constancees/BMI-EMG-HW-Constance/CAD files/Bracelet 1/Assembly - Canal v12.iges

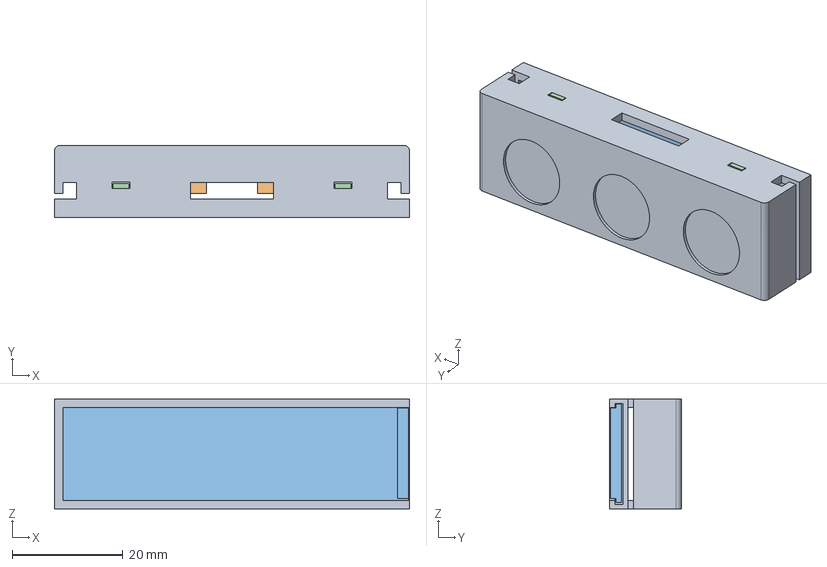
[picture p1: CAD file, 2026-05-24]
CAD files/Bracelet 1/Assembly - Canal v12.iges
64.0 x 13.0 x 19.8 mm
