constancees/BMI-EMG-HW-Constance/CAD files/Bracelet 2/Canal - Assembly v11.iges

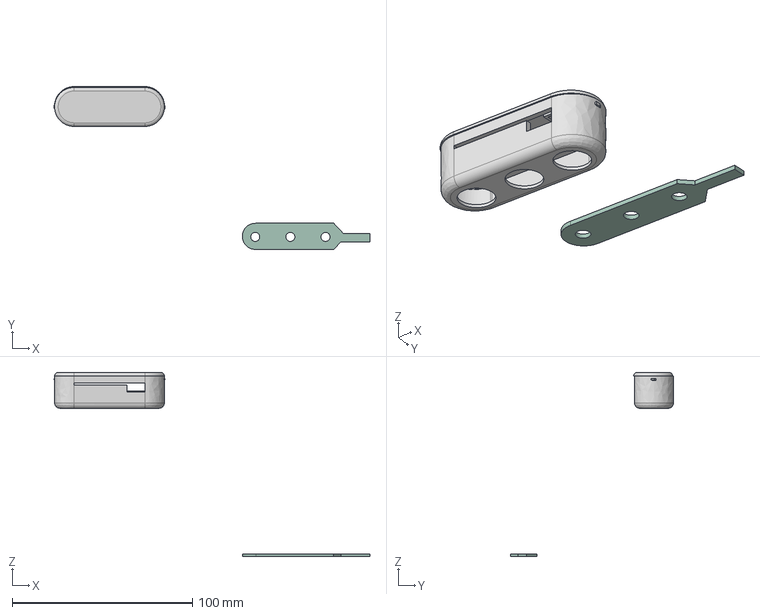
[picture p2: CAD file, 2026-05-24]
CAD files/Bracelet 2/Canal - Assembly v11.iges
175.3 x 90.4 x 102.3 mm
