constancees/BMI-EMG-HW-Constance/CAD files/Bracelet 1/Assembly - Control Board v1.iges

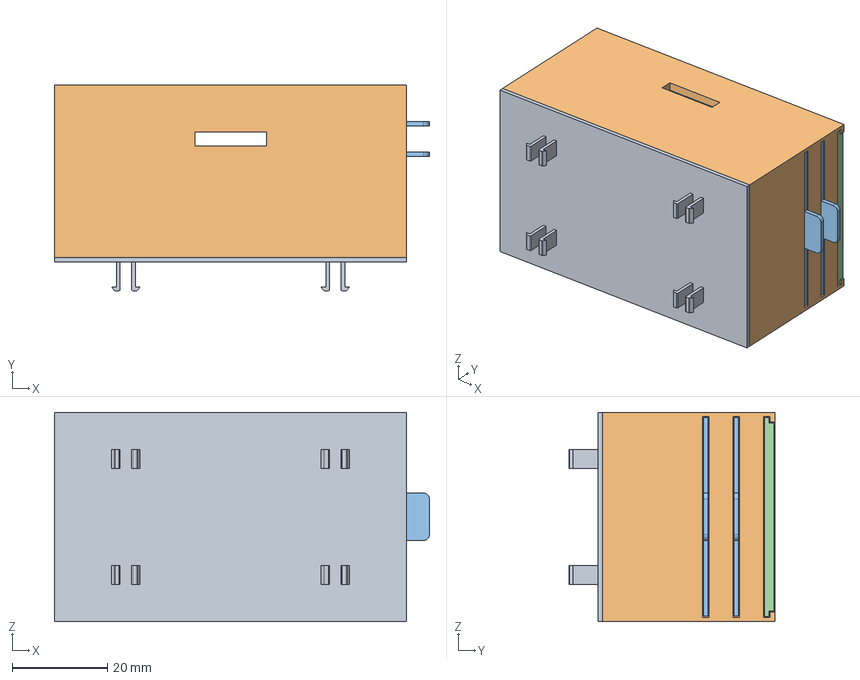
[picture p3: CAD file, 2026-05-24]
CAD files/Bracelet 1/Assembly - Control Board v1.iges
78.8 x 43.2 x 44.0 mm
