constancees/BMI-EMG-HW-Constance/CAD files/Bracelet 1/Canal - main base v9.iges

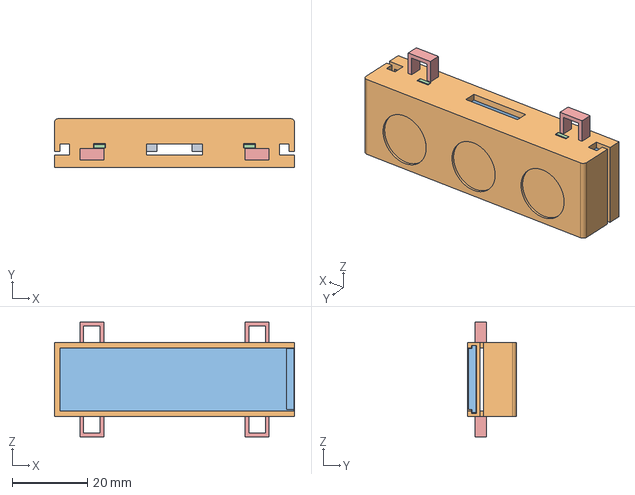
[picture p4: CAD file, 2026-05-24]
CAD files/Bracelet 1/Canal - main base v9.iges
64.0 x 13.0 x 30.6 mm
