constancees/BMI-EMG-HW-Constance/POWERBOARD v3/power_v3.3/APP2281-1FMG-7/AP2281-1FMG-7.stp

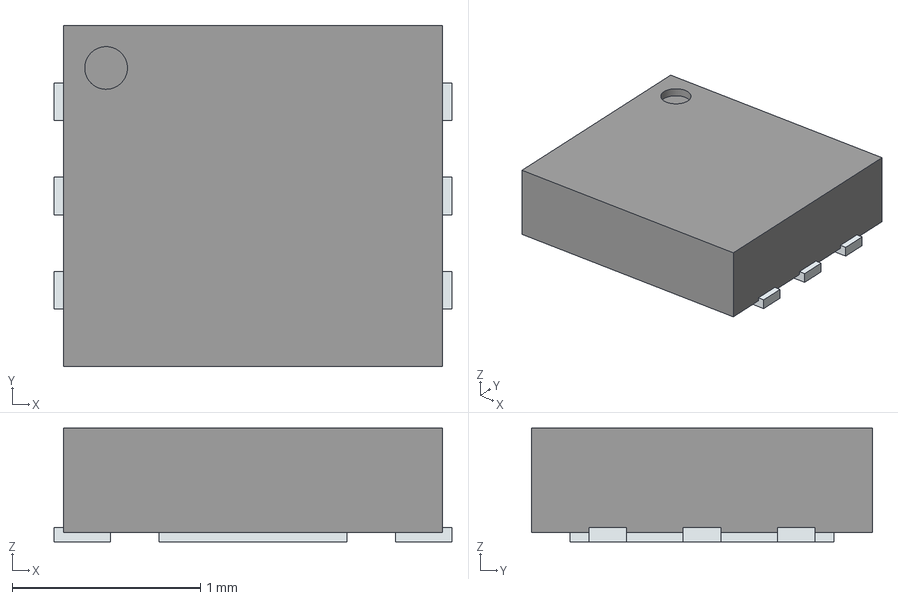
[picture p5: CAD file, 2026-10-09]
POWERBOARD v3/power_v3.3/APP2281-1FMG-7/AP2281-1FMG-7.stp
2.11 x 1.81 x 0.605 mm
ThermalPin
PinsArrayLR
