constancees/BMI-EMG-HW-Constance/POWERBOARD v3/power_v3.3/MCP6541T-I_OT/MCP6541T-I_OT.stp

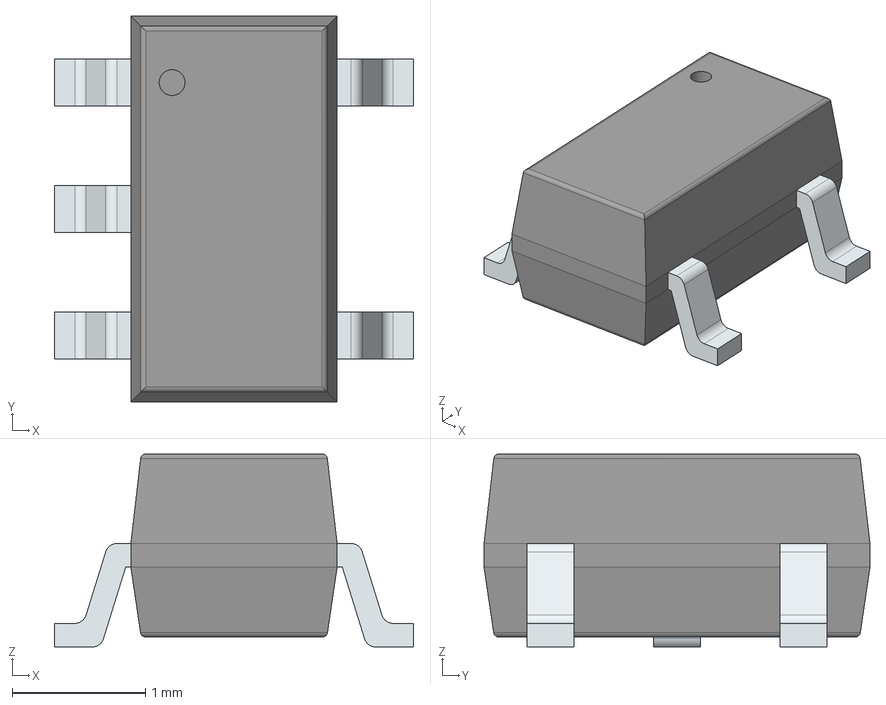
[picture p6: CAD file, 2026-10-09]
POWERBOARD v3/power_v3.3/MCP6541T-I_OT/MCP6541T-I_OT.stp
2.70 x 2.90 x 1.45 mm
PinsArrayL
PinsArrayR
