constancees/BMI-EMG-HW-Constance/POWERBOARD v3/power_v3.3/MFS201N-9-Z/MFS201N-9-Z.stp

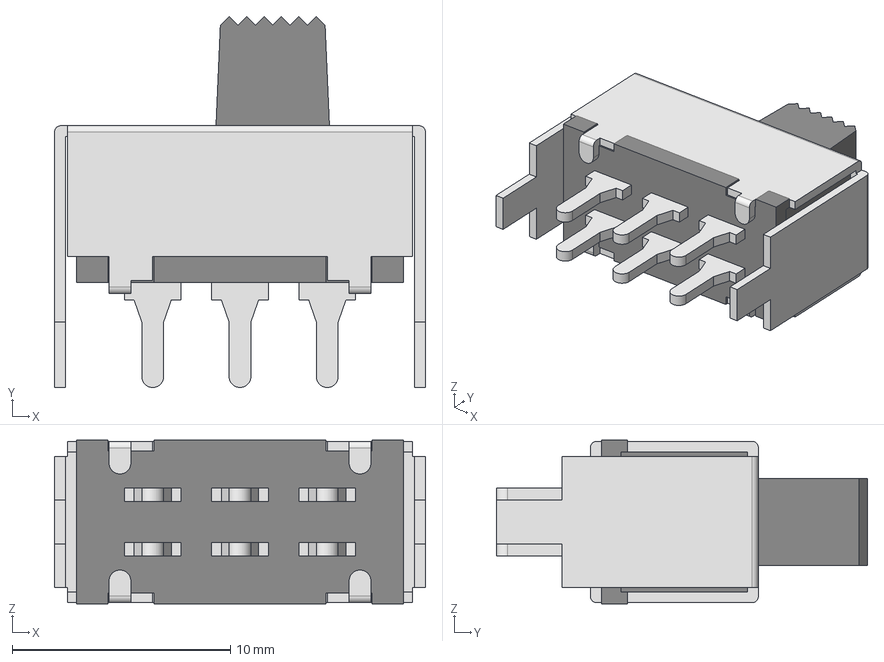
[picture p7: CAD file, 2026-10-09]
POWERBOARD v3/power_v3.3/MFS201N-9-Z/MFS201N-9-Z.stp
17.0 x 17.0 x 7.50 mm
MFS201N-9-Z_b
MFS201N910_bu
