constancees/BMI-EMG-HW-Constance/POWERBOARD v3/power_v3.3/SMBJ9.0A/SMBJ9.0A.stp

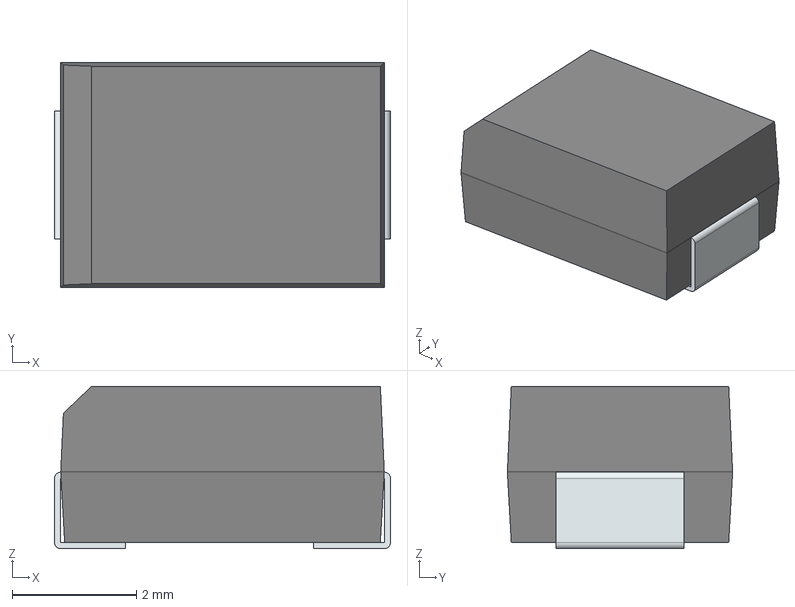
[picture p8: CAD file, 2026-10-09]
POWERBOARD v3/power_v3.3/SMBJ9.0A/SMBJ9.0A.stp
5.40 x 3.62 x 2.61 mm
FilletPin1
FilletPin2
