constancees/BMI-EMG-HW-Constance/POWERBOARD v3/power_v3.3/switchonoff/5MS1S102AM6QES.stp

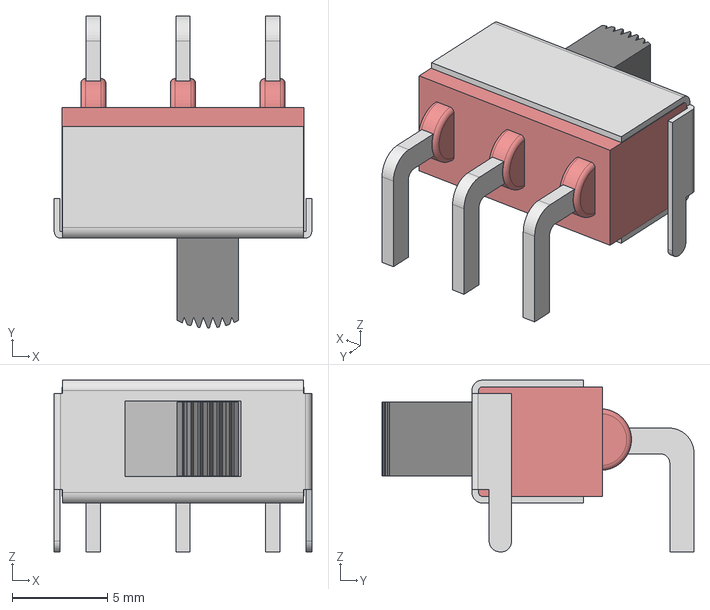
[picture p9: CAD file, 2026-10-09]
POWERBOARD v3/power_v3.3/switchonoff/5MS1S102AM6QES.stp
13.5 x 16.4 x 9.01 mm
