constancees/BMI-EMG-HW-Constance/POWERBOARD v3/power_v3.3/UJ20_C_H_G_SMT_1_P16_TR/UJ20-C-H-G-SMT-1-P16-TR.step

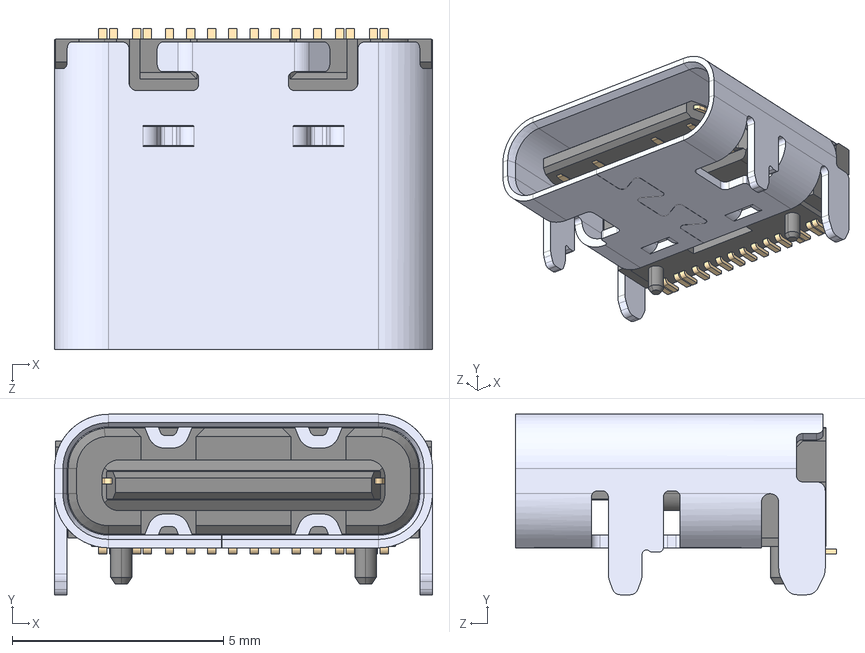
[picture p10: CAD file, 2026-10-08]
POWERBOARD v3/power_v3.3/UJ20_C_H_G_SMT_1_P16_TR/UJ20-C-H-G-SMT-1-P16-TR.step
8.94 x 4.27 x 7.60 mm
