constancees/BMI-EMG-HW-Constance/POWERBOARD v3/power_v3.3/2053380003.stp

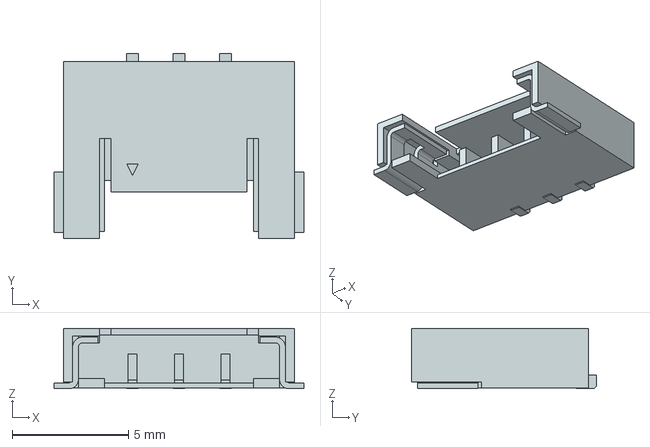
[picture p11: CAD file, 2026-10-09]
POWERBOARD v3/power_v3.3/2053380003.stp
10.7 x 7.95 x 2.60 mm
