constancees/BMI-EMG-HW-Constance/POWERBOARD v3/power_v3.3/74438336010/3D/74438336010.stp

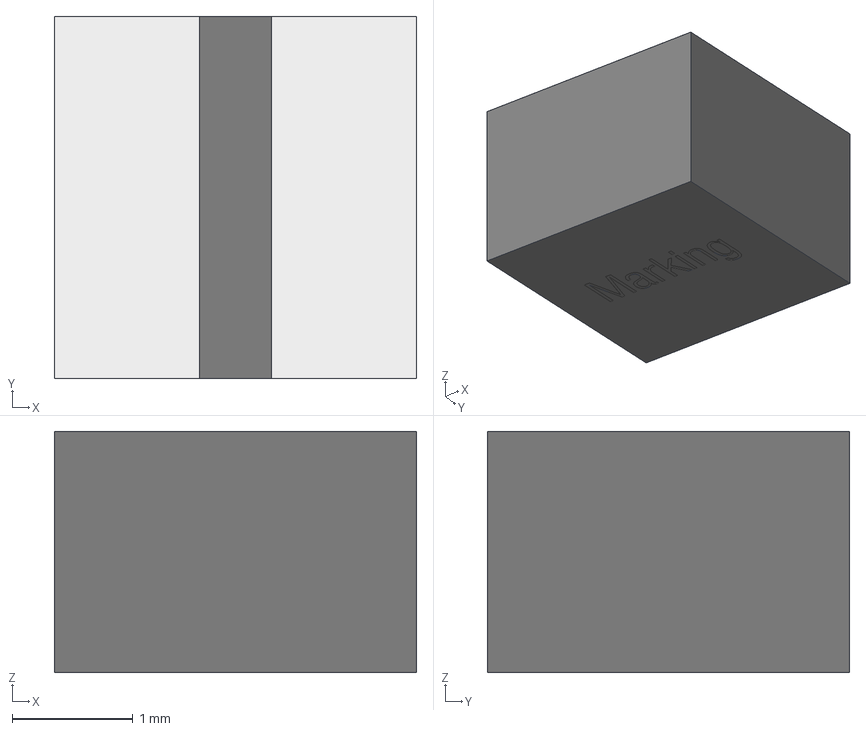
[picture p12: CAD file, 2026-10-07]
POWERBOARD v3/power_v3.3/74438336010/3D/74438336010.stp
3.00 x 3.00 x 2.00 mm
