constancees/BMI-EMG-HW-Constance/POWERBOARD v3/power_v3.3/bat_connect_new/43650-0300.stp

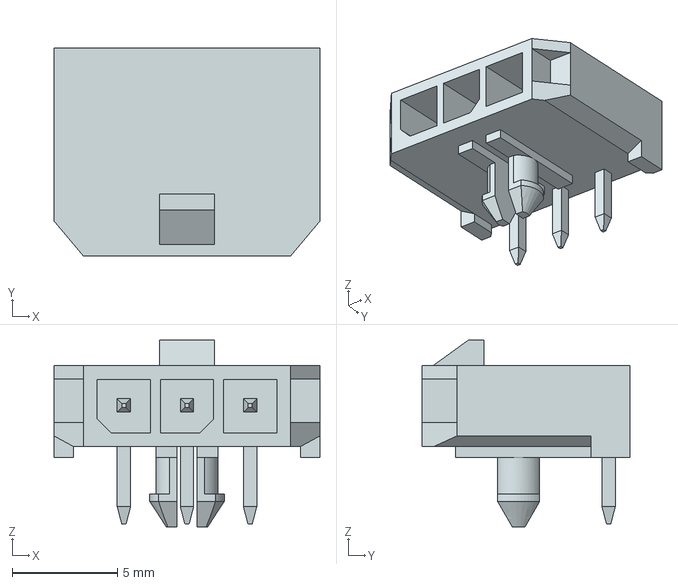
[picture p13: CAD file, 2026-10-09]
POWERBOARD v3/power_v3.3/bat_connect_new/43650-0300.stp
12.7 x 9.90 x 8.87 mm
