constancees/BMI-EMG-HW-Constance/POWERBOARD v3/power_v3.3/MAX25301AATB_V+T/MAX25301AATB_V+T.stp

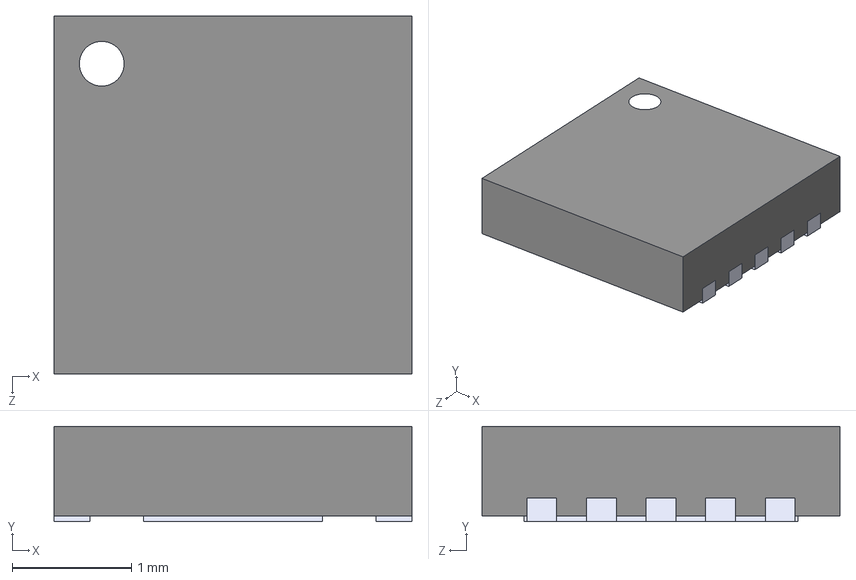
[picture p14: CAD file, 2026-10-09]
POWERBOARD v3/power_v3.3/MAX25301AATB_V+T/MAX25301AATB_V+T.stp
3.00 x 0.8 x 3.00 mm
