constancees/BMI-EMG-HW-Constance/POWERBOARD v3/power_v3.3/molex2/2053380002.stp

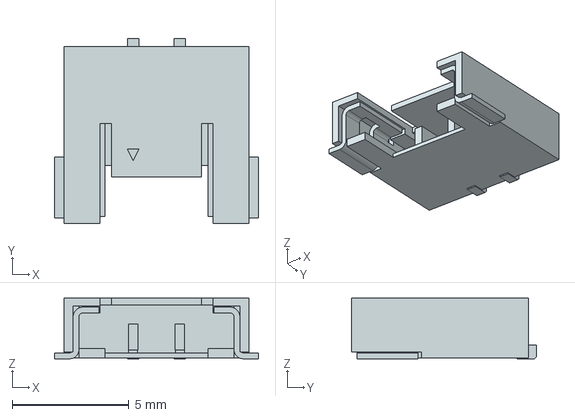
[picture p15: CAD file, 2026-10-09]
POWERBOARD v3/power_v3.3/molex2/2053380002.stp
8.75 x 7.95 x 2.60 mm
