constancees/BMI-EMG-HW-Constance/POWERBOARD v3/power_v3.3/TPS62160DSGT/TPS62160DSGT.stp

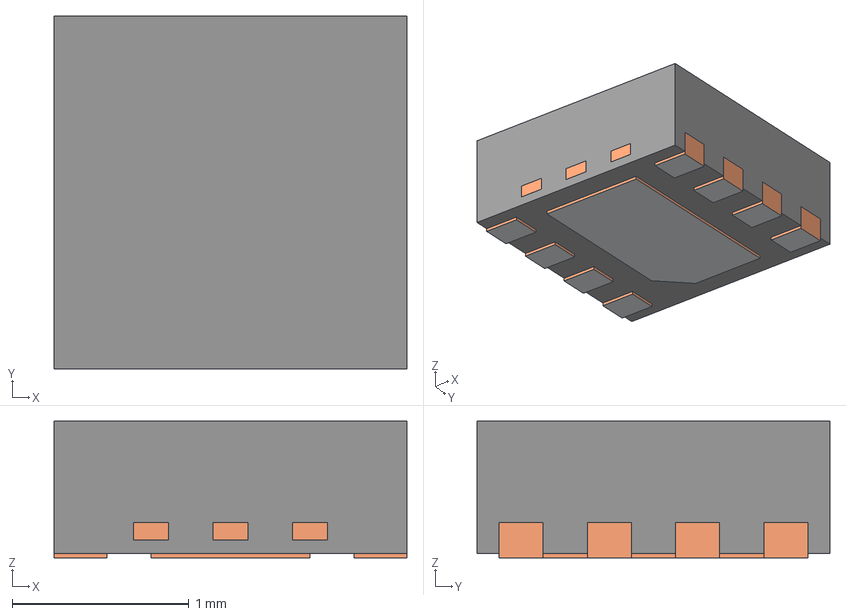
[picture p16: CAD file, 2026-10-09]
POWERBOARD v3/power_v3.3/TPS62160DSGT/TPS62160DSGT.stp
2.00 x 2.00 x 0.775 mm
BODY-SON
FRAME-DSG0008A
PIN1-ID
