constancees/BMI-EMG-HW-Constance/CAD files/Bracelet 1/Canal - main base v2.iges

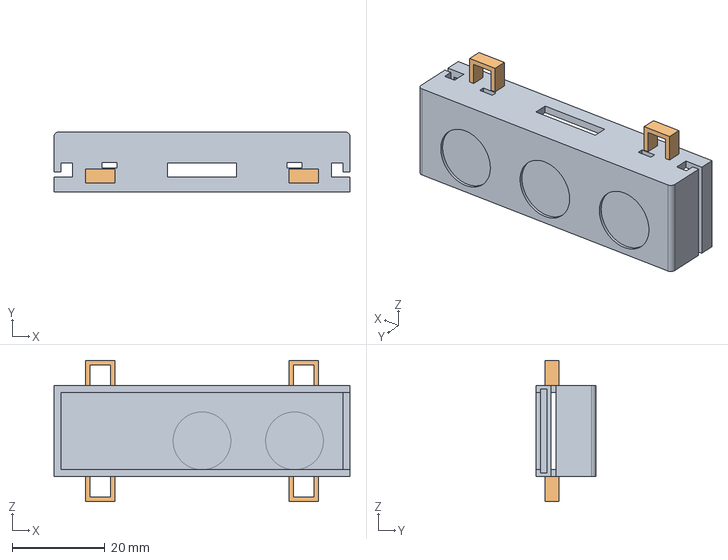
[picture p17: CAD file, 2026-05-24, an earlier design]
CAD files/Bracelet 1/Canal - main base v2.iges
64.0 x 13.0 x 30.6 mm
