constancees/BMI-EMG-HW-Constance/(list of files, cad)

Other CAD files:
POWERBOARD v3/power_v3.3/78438336022/78438336022.stp
CAD files/Bracelet 1/Canal - base v22.f3d
CAD files/Bracelet 1/Canal - blocker v2.f3d
CAD files/Bracelet 1/Canal - middle plate v8.f3d
CAD files/Bracelet 1/Canal - top plate v3.f3d
CAD files/Bracelet 1/Control board - base v10.f3d
CAD files/Bracelet 1/Control board - middle high plate v2.f3d
CAD files/Bracelet 1/Control board - middle low plate v4.f3d
CAD files/Bracelet 1/Control board - top plate v1.f3d
CAD files/Bracelet 2/Canal - Middle plate v10.f3d
CAD files/Bracelet 2/Canal - base v21.f3d
CAD files/Bracelet 2/Canal - ressort v4.f3d
CAD files/Bracelet 2/Canal - top plate bar v2.f3d
CAD files/Bracelet 2/Canal - top plate v12.f3d
CAD files/Bracelet 2/Control board - base v4.f3d
CAD files/Bracelet 2/Control board - middle plate v2.f3d
CAD files/Bracelet 2/Control board - top plate v2.f3d
CAD files/Canal - base test v3.f3d
POWERBOARD v3/power_v3.3/74438336010/DEHDL/74438336010/chips/chips.prt
