constancees/BMI-EMG-HW-Constance/(list of files, drawings)

Other design files:
POWERBOARD v3/power_v3.3/74438336010/Altium/74438336010.SchLib
POWERBOARD v3/power_v3.3/74438336010/Altium/INDC3030X200N.PcbLib
