constancees/BMI-EMG-HW-Constance/POWERBOARD v3/power_v3.3/power_v3.3.kicad_pcb

## KiCad design POWERBOARD v3/power_v3.3/power_v3.3.kicad_pcb (2026-10-09)

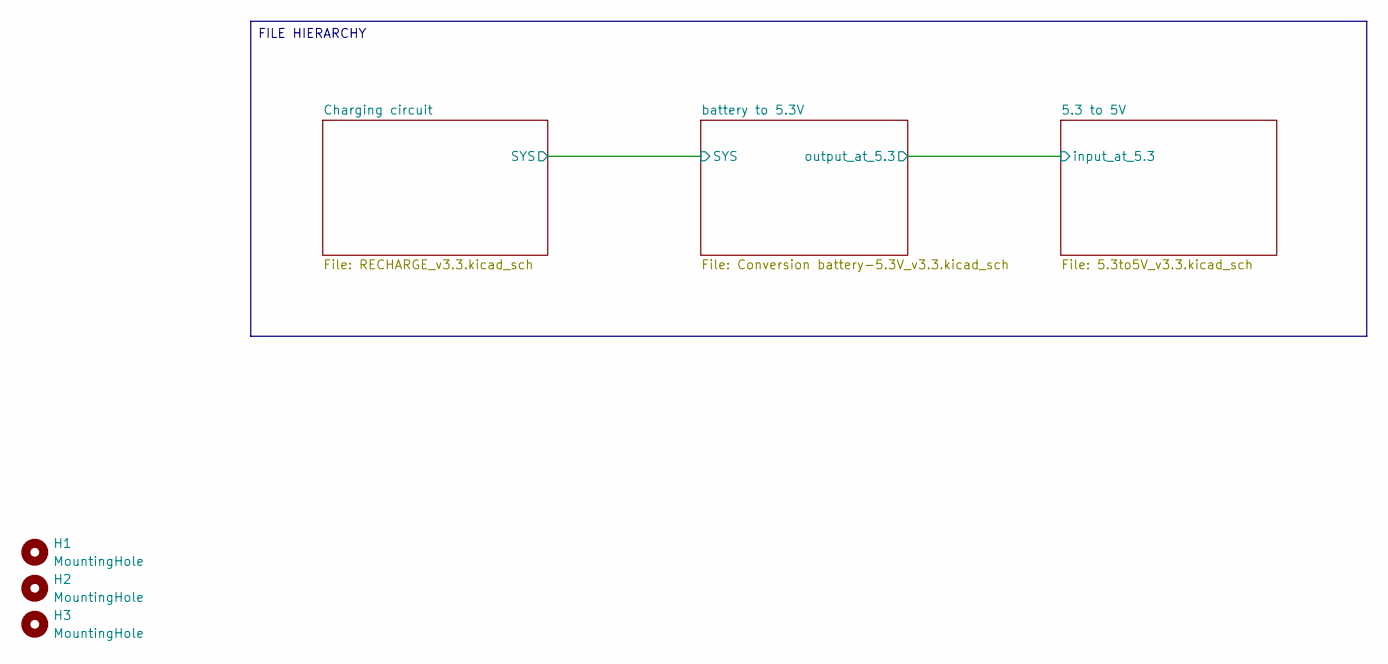
[picture p18: schematic power_v3.3.kicad_sch]

Parts:
H1, H2, H3: MountingHole; MountingHole_2.2mm_M2_DIN965_Pad

Notes on the sheet:
FILE HIERARCHY

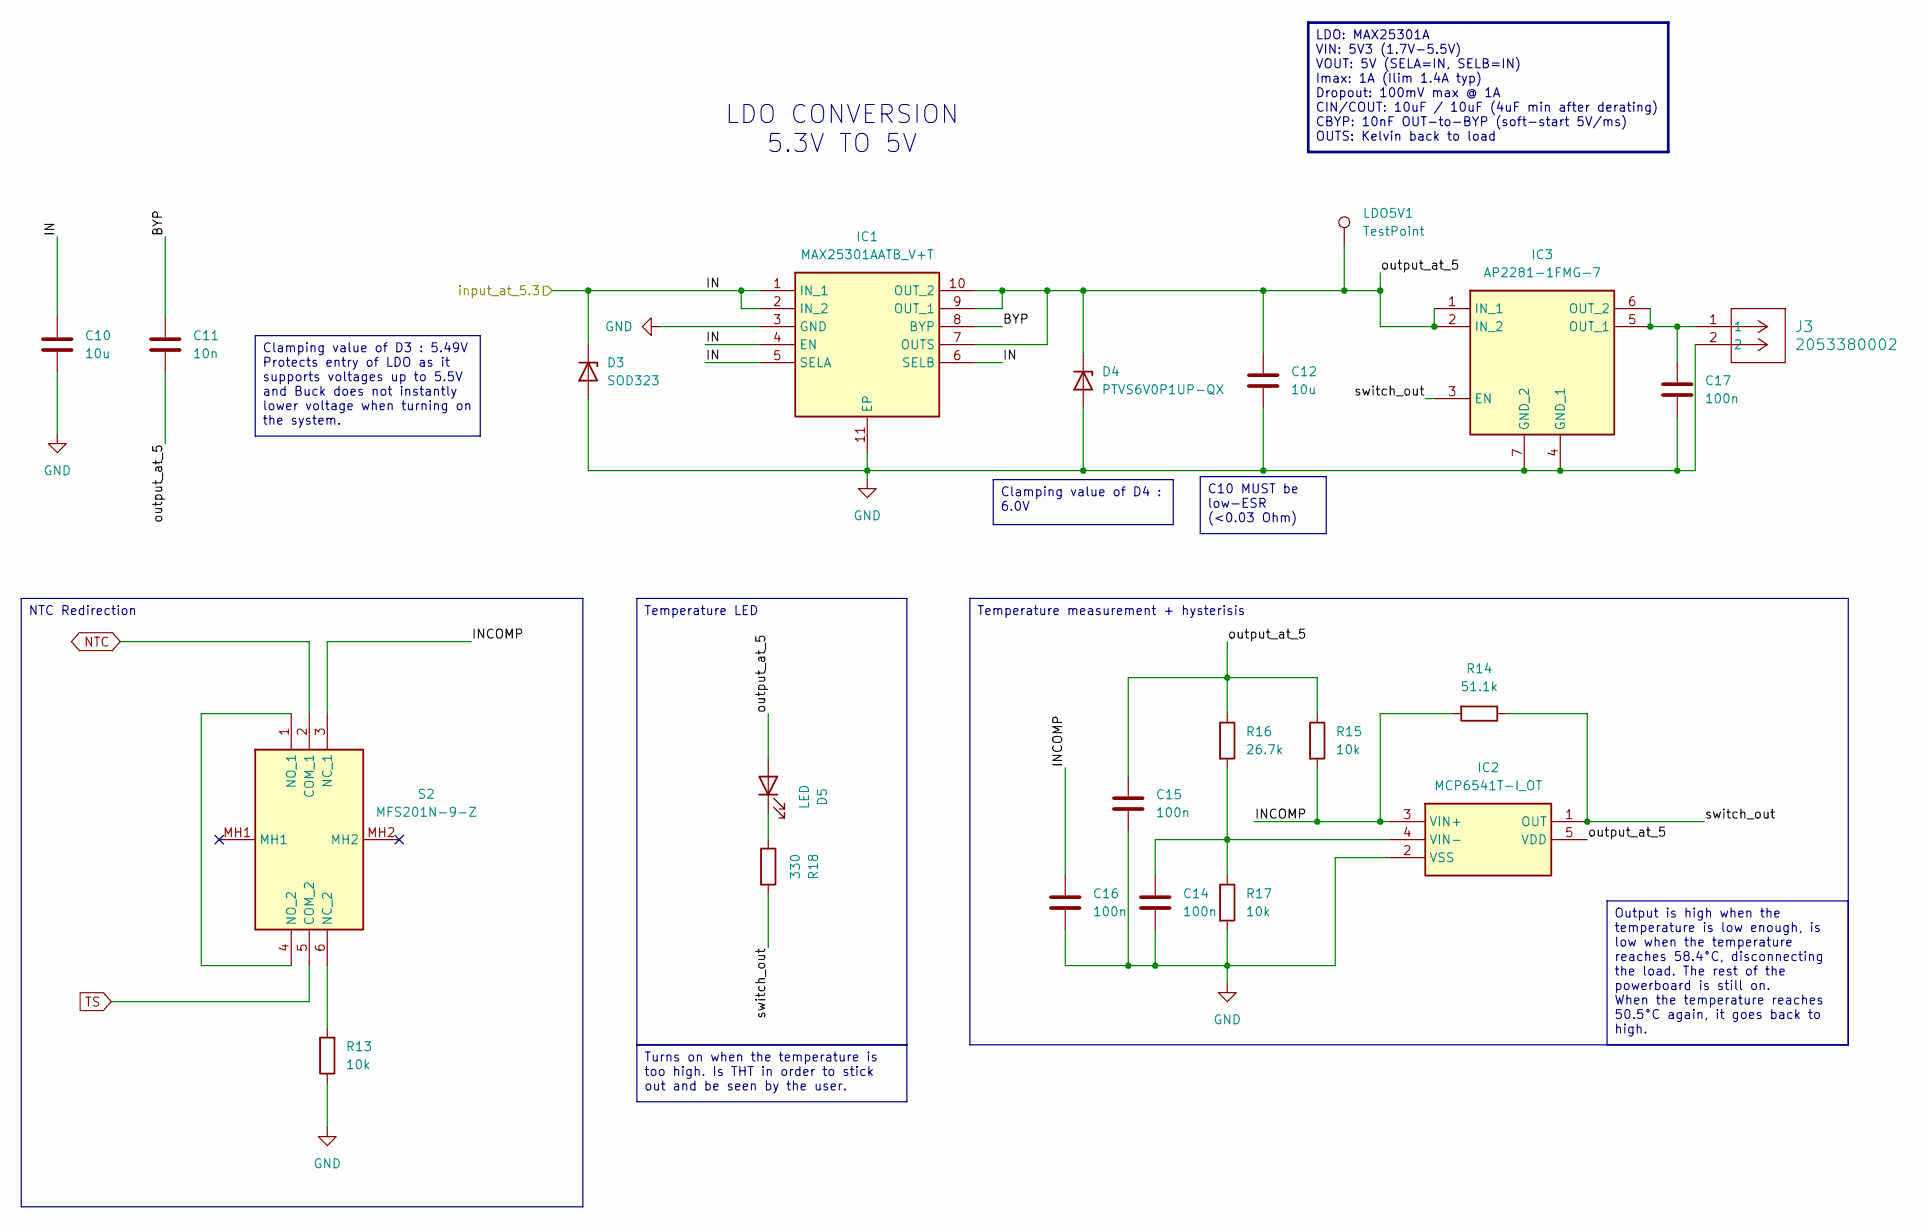
[picture p19: schematic 5.3to5V_v3.3.kicad_sch]

Parts:
C10, C12: 10u; C_0805_2012Metric
C11: 10n; C_0402_1005Metric
C14, C15, C16, C17: 100n; C_0402_1005Metric
D3: SOD323; SOT-23
D4: PTVS6V0P1UP-QX; D_SOD-128
D5: LED; LED_D5.0mm
IC1: MAX25301AATB_V+T; SON50P300X300X80-11N; Mouser Part Number 700-MAX25301AATB/V+T
IC2: MCP6541T-I_OT; SOT95P270X145-5N; Mouser Part Number 579-MCP6541T-I/OT
IC3: AP2281-1FMG-7; SON50P201X181X60-7N; Mouser Part Number 621-AP2281-1FMG-7
J3: 2053380002; CONN_2053380000-SD_02_MOL
LDO5V1: TestPoint; TestPoint_Keystone_5000-5004_Miniature
R13, R15, R17: 10k; R_0603_1608Metric
R14: 51.1k; R_0603_1608Metric
R16: 26.7k; R_0603_1608Metric
R18: 330; R_0603_1608Metric
S2: MFS201N-9-Z; MFS201N9Z; Mouser Part Number 229-MFS201N-9-Z

Connections:
/5.3 to 5V/BYP: C11.1, IC1.8 (BYP)
/5.3 to 5V/IN: C10.1, D3.1 (K), IC1.1 (IN_1), IC1.2 (IN_2), IC1.4 (EN), IC1.5 (SELA), IC1.6 (SELB); also elsewhere on the board
/5.3 to 5V/INCOMP: C16.1, IC2.3 (VIN+), R14.2, R15.2, S2.3 (NC_1)
/5.3 to 5V/output_at_5: C11.2, C12.1, C15.1, D4.1 (K), D5.2 (A), IC1.7 (OUTS), IC1.9 (OUT_1), IC1.10 (OUT_2), IC2.5 (VDD), IC3.1 (IN_1), IC3.2 (IN_2), LDO5V1.1 (1_1), R15.1, R16.1
/5.3 to 5V/switch_out: IC2.1 (OUT), IC3.3 (EN), R14.1, R18.2
GND: C10.2, C12.2, C14.2, C15.2, C16.2, C17.2, D3.2 (A), D4.2 (A), IC1.3 (GND), IC1.11 (EP), IC2.2 (VSS), IC3.4 (GND_1), IC3.7 (GND_2), J3.2, R13.1, R17.2; also elsewhere on the board
NTC: S2.2 (COM_1), S2.5 (COM_2); also elsewhere on the board
unnamed: D5.1 (K), R18.1
unnamed: C14.1, IC2.4 (VIN-), R16.2, R17.1
unnamed: C17.1, IC3.5 (OUT_1), IC3.6 (OUT_2), J3.1
unnamed: R13.2, S2.6 (NC_2)
unnamed: S2.1 (NO_1), S2.4 (NO_2)

Notes on the sheet:
LDO CONVERSION 5.3V TO 5V
LDO: MAX25301A VIN: 5V3 (1.7V-5.5V) VOUT: 5V (SELA=IN, SELB=IN) Imax: 1A (Ilim 1.4A typ) Dropout: 100mV max @ 1A CIN/COUT: 10uF / 10uF (4uF min after derating) CBYP: 10nF OUT-to-BYP (soft-start 5V/ms) OUTS: Kelvin back to load
Clamping value of D4 : 6.0V
Temperature LED
Clamping value of D3 : 5.49V Protects entry of LDO as it supports voltages up to 5.5V and Buck does not instantly lower voltage when turning on the system.
C10 MUST be low-ESR (<0.03 Ohm)
Temperature measurement + hysterisis
Output is high when the temperature is low enough, is low when the temperature reaches 58.4°C, disconnecting the load. The rest of the powerboard is still on. When the temperature reaches 50.5°C again, it goes back to high.
Turns on when the temperature is too high. Is THT in order to stick out and be seen by the user.
NTC Redirection

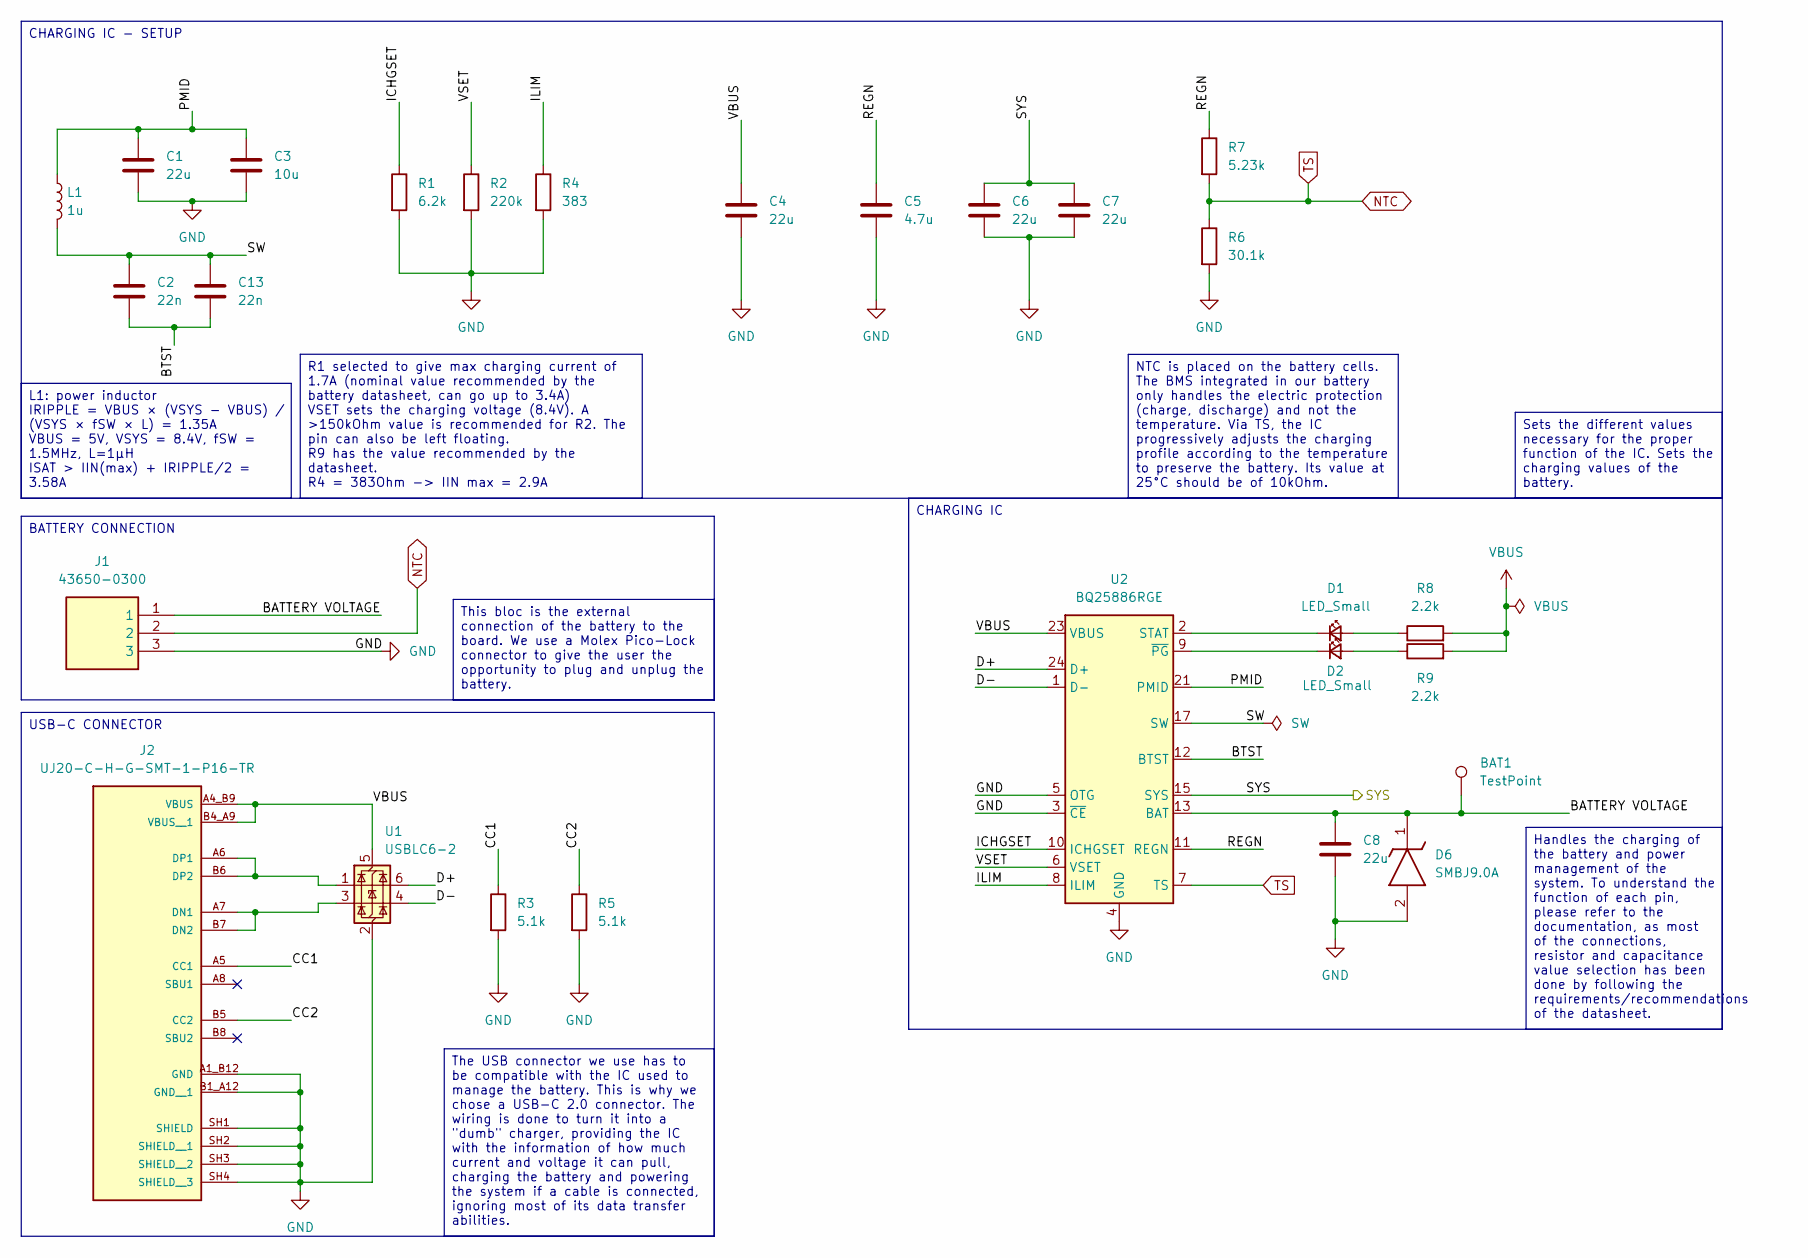
[picture p20: schematic RECHARGE_v3.3.kicad_sch]

Parts:
BAT1: TestPoint; TestPoint_Keystone_5000-5004_Miniature
C1, C4, C6, C7, C8: 22u; C_1206_3216Metric
C2, C13: 22n; C_0201_0603Metric
C3: 10u; C_0805_2012Metric
C5: 4.7u; C_0805_2012Metric
D1, D2: LED_Small; LED_0603_1608Metric
D6: SMBJ9.0A; DIOM5436X261N; Manufacturer_Part_Number SMBJ9.0A
J1: 43650-0300; 436500300; Mouser Part Number 538-43650-0300
J2: UJ20-C-H-G-SMT-1-P16-TR; SAMESKY_UJ20-C-H-G-SMT-1-P16-TR; PARTREV 1.0
L1: 1u; INDC3030X200N
R1: 6.2k; R_0603_1608Metric
R2: 220k; R_0603_1608Metric
R3, R5: 5.1k; R_0603_1608Metric
R4: 383; R_0603_1608Metric
R6: 30.1k; R_0603_1608Metric
R7: 5.23k; R_0603_1608Metric
R8, R9: 2.2k; R_0603_1608Metric
U1: USBLC6-2; SOT-23-6
U2: BQ25886RGE; Texas_RGE0024H_VQFN-24-1EP_4x4mm_P0.5mm_EP2.7x2.7mm

Connections:
/Charging circuit/BATTERY VOLTAGE: BAT1.1 (1_1), C8.1, D6.1 (K), J1.1, U2.13 (BAT), U2.14 (BAT)
/Charging circuit/BTST: C2.2, C13.2, U2.12 (BTST)
/Charging circuit/CC1: J2.A5 (CC1), R3.1
/Charging circuit/CC2: J2.B5 (CC2), R5.1
/Charging circuit/D+: U1.6 (I/O1), U2.24 (D+)
/Charging circuit/D-: U1.4 (I/O2), U2.1 (D-)
/Charging circuit/ICHGSET: R1.1, U2.10 (ICHGSET)
/Charging circuit/ILIM: R4.1, U2.8 (ILIM)
/Charging circuit/PMID: C1.1, C3.1, L1.1, U2.21 (PMID), U2.22 (PMID)
/Charging circuit/REGN: C5.1, R7.1, U2.11 (REGN)
/Charging circuit/SW: C2.1, C13.1, L1.2, U2.17 (SW), U2.18 (SW)
/Charging circuit/SYS: C6.1, C7.1, U2.15 (SYS), U2.16 (SYS); also elsewhere on the board
/Charging circuit/VSET: R2.1, U2.6 (VSET)
GND: C1.2, C3.2, C4.2, C5.2, C6.2, C7.2, C8.2, D6.2 (A), J1.3, J2.A1_B12 (GND), J2.B1_A12 (GND__1), J2.SH1 (SHIELD), J2.SH2 (SHIELD__1), J2.SH3 (SHIELD__2), J2.SH4 (SHIELD__3), R1.2, R2.2, R3.2, R4.2, R5.2, R6.2, U1.2 (GND), U2.3 (~CE), U2.4 (GND), U2.5 (OTG), U2.19 (GND), U2.20 (GND), U2.25 (GND); also elsewhere on the board
NTC: J1.2, R6.1, R7.2, U2.7 (TS); also elsewhere on the board
unnamed: D1.2 (A), R8.1
unnamed: D1.1 (K), U2.2 (STAT)
unnamed: D2.2 (A), R9.1
unnamed: D2.1 (K), U2.9 (~PG)
unnamed: J2.A7 (DN1), J2.B7 (DN2), U1.3 (I/O2)
unnamed: J2.A6 (DP1), J2.B6 (DP2), U1.1 (I/O1)
VBUS: C4.1, J2.A4_B9 (VBUS), J2.B4_A9 (VBUS__1), R8.2, R9.2, U1.5 (VBUS), U2.23 (VBUS)

Notes on the sheet:
R1 selected to give max charging current of 1.7A (nominal value recommended by the battery datasheet, can go up to 3.4A) VSET sets the charging voltage (8.4V). A >150kOhm value is recommended for R2. The pin can also be left floating. R9 has the value recommended by the datasheet. R4 = 383Ohm -> II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
This bloc is the external connection of the battery to the board. We use a Molex Pico-Lock connector to give the user the opportunity to plug and unplug the battery.
BATTERY CONNECTION
Sets the different values necessary for the proper function of the IC. Sets the charging values of the battery.
CHARGING IC - SETUP
Handles the charging of the battery and power management of the system. To understand the function of each pin, please refer to the documentation, as most of the connections, resistor and capacitance value selection has been done by following the requirements/recommendations of the datasheet.
CHARGING IC
NTC is placed on the battery cells. The BMS integrated in our battery only handles the electric protection (charge, discharge) and not the temperature. Via TS, the IC progressively adjusts the charging profile according to the temperature to preserve the battery. Its value at 25°C should be of 10kO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
USB-C CONNECTOR
The USB connector we use has to be compatible with the IC used to manage the battery. This is why we chose a USB-C 2.0 connector. The wiring is done to turn it into a "dumb" charger, providing the IC with the information of how much current and voltage it can pull, charging the battery and powering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
L1: power inductor IRIPPLE = VBUS × (VSYS − VBUS) / (VSYS × fSW × L) = 1.35A VBUS = 5V, VSYS = 8.4V, fSW = 1.5MHz, L=1µH ISAT > IIN(max) + IRIPPLE/2 = 3.58A

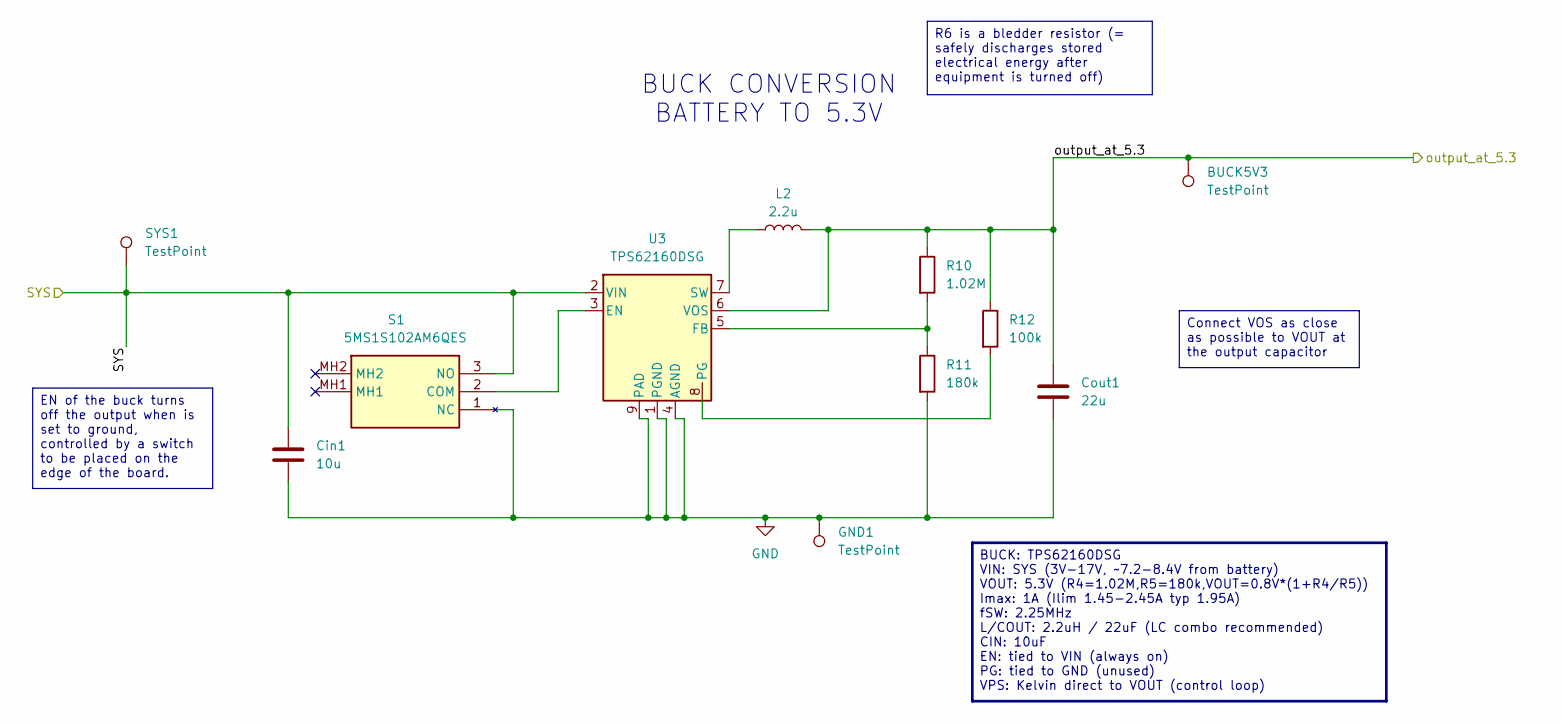
[picture p21: schematic Conversion battery-5.3V_v3.3.kicad_sch]

Parts:
BUCK5V3: TestPoint; TestPoint_Keystone_5000-5004_Miniature
Cin1: 10u; C_0805_2012Metric
Cout1: 22u; C_1206_3216Metric
GND1: TestPoint; TestPoint_Keystone_5000-5004_Miniature
L2: 2.2u; 78438336022
R10: 1.02M; R_0603_1608Metric
R11: 180k; R_0603_1608Metric
R12: 100k; R_0603_1608Metric
S1: 5MS1S102AM6QES; Mouser Part Number 118-5MS1S102AM6QES
SYS1: TestPoint; TestPoint_Keystone_5000-5004_Miniature
U3: TPS62160DSG; SON50P200X200X80-9N

Connections:
/5.3 to 5V/IN: BUCK5V3.1 (1_1), Cout1.1, L2.2, R10.1, R12.1, U3.6 (VOS); also elsewhere on the board
/Charging circuit/SYS: Cin1.1, S1.3 (NO), SYS1.1 (1_1), U3.2 (VIN); also elsewhere on the board
GND: Cin1.2, Cout1.2, GND1.1 (1_1), R11.2, S1.1 (NC), U3.1 (PGND), U3.4 (AGND), U3.9 (PAD); also elsewhere on the board
unnamed: S1.2 (COM), U3.3 (EN)
unnamed: R10.2, R11.1, U3.5 (FB)
unnamed: R12.2, U3.8 (PG)
unnamed: L2.1, U3.7 (SW)

Notes on the sheet:
BUCK CONVERSION BATTERY TO 5.3V
BUCK: TPS62160DSG VIN: SYS (3V-17V, ~7.2-8.4V from battery) VOUT: 5.3V (R4=1.02M,R5=180k,VOUT=0.8V*(1+R4/R5)) Imax: 1A (Ilim 1.45-2.45A typ 1.95A) fSW: 2.25MHz L/COUT: 2.2uH / 22uF (LC combo recommended) CIN: 10uF EN: tied to VIN (always on) PG: tied to GND (unused) VPS: Kelvin direct to VOUT (cont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
EN of the buck turns off the output when is set to ground, controlled by a switch to be placed on the edge of the board.
Connect VOS as close as possible to VOUT at the output capacitor
R6 is a bledder resistor (= safely discharges stored electrical energy after equipment is turned off)

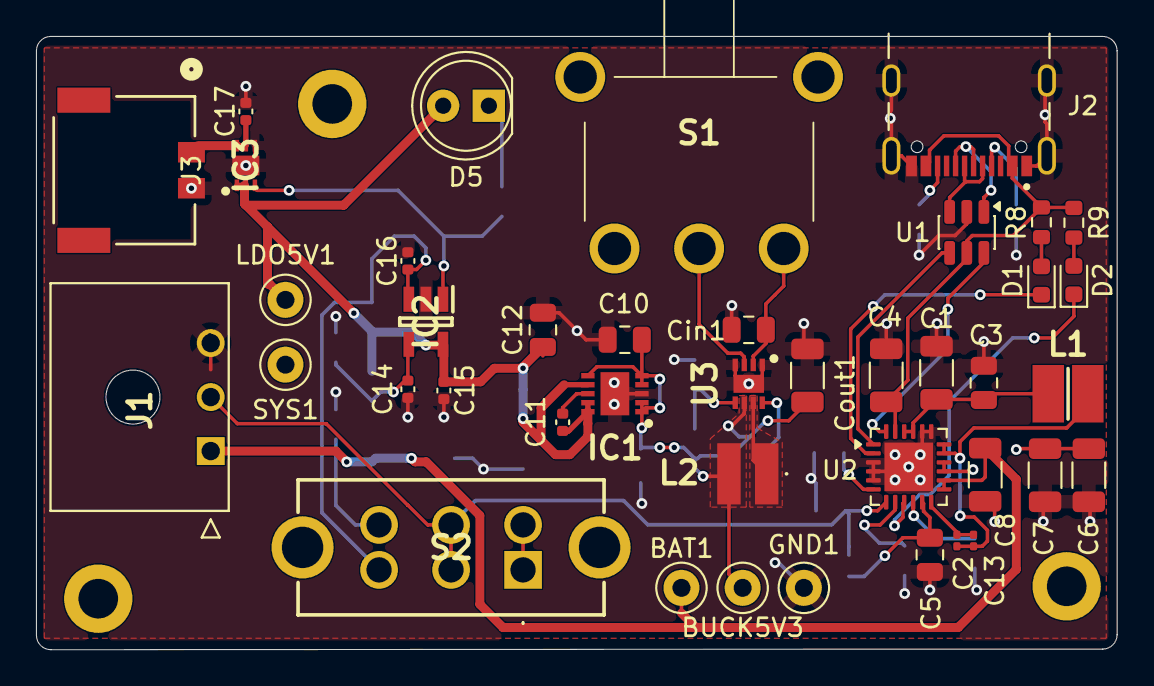
[picture p22: board power_v3.3.kicad_pcb from above]

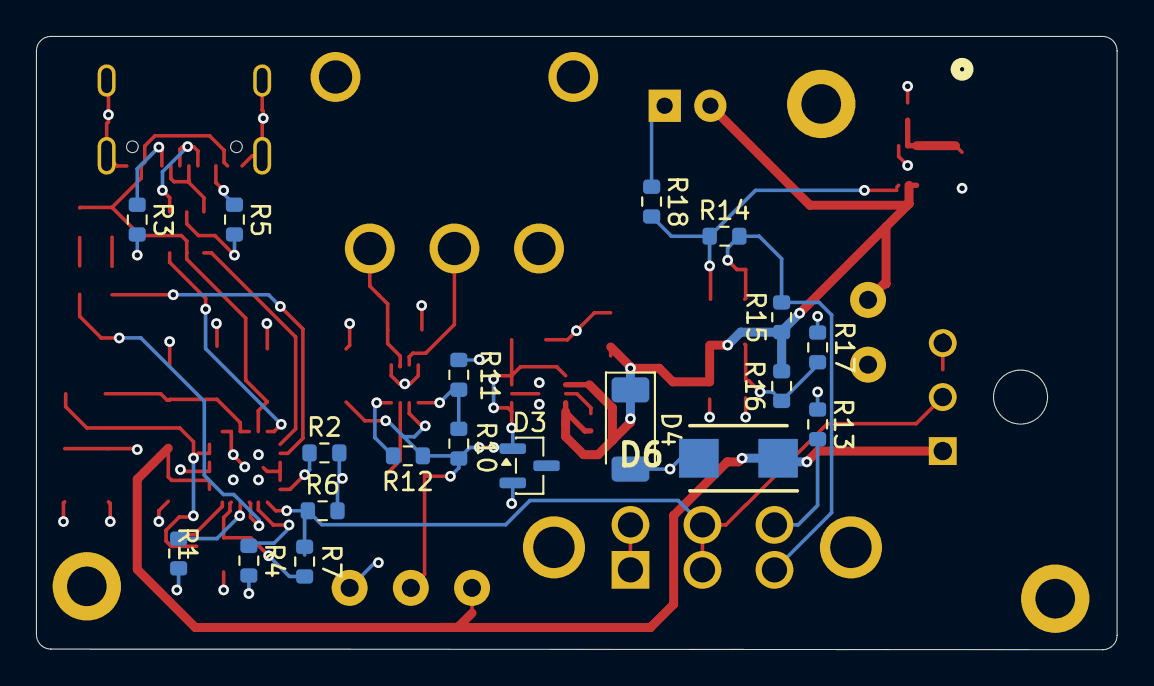
[picture p23: board power_v3.3.kicad_pcb from below]

Board: 4 copper layers, 60.0 x 34.1 mm, 63 parts (19 on the bottom side), 36 nets.
