constancees/BMI-EMG-HW-Constance/Board V3/Processing_board.kicad_pcb

## KiCad design Board V3/Processing_board.kicad_pcb (2026-08-18)

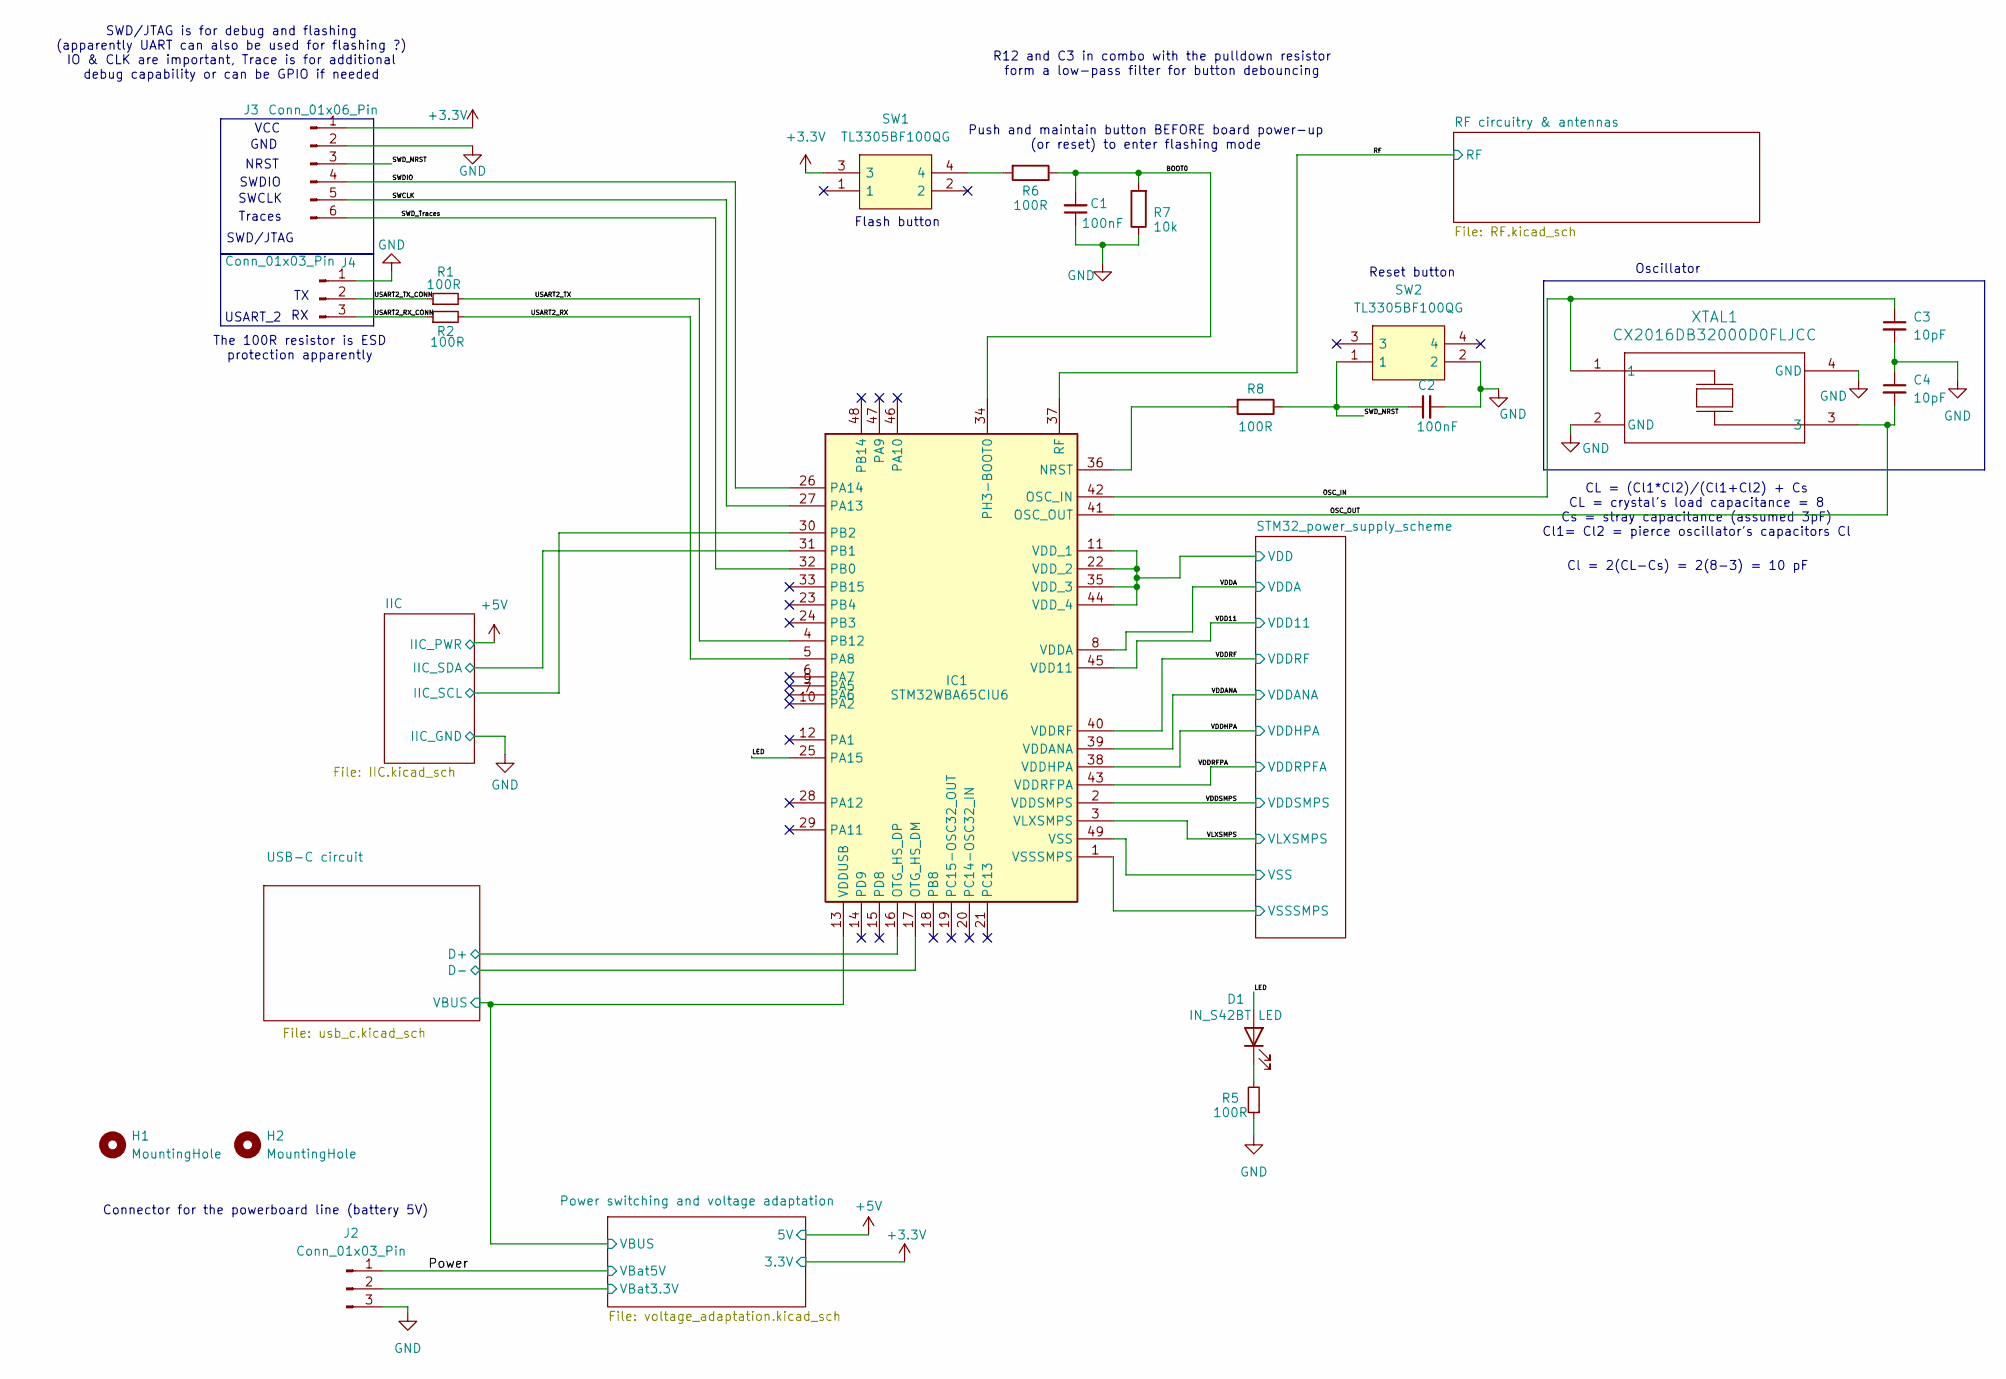
[picture p24: schematic Processing_board.kicad_sch, EMG signal processing board]

Parts:
C1, C2: 100nF; C_0402_1005Metric
C3, C4: 10pF; C_0603_1608Metric
D1: IN_S42BT LED; LED_0402_1005Metric
H1, H2: MountingHole; MountingHole_2.2mm_M2
IC1: STM32WBA65CIU6; QFN50P700X700X60-49N-D; Manufacturer_Part_Number STM32WBA65CIU6
J2: Conn_01x03_Pin; JST_PH_B3B-PH-K_1x03_P2.00mm_Vertical
J3: Conn_01x06_Pin; PinHeader_1x06_P2.54mm_Vertical_SMD_Pin1Left
J4: Conn_01x03_Pin; PinHeader_1x03_P2.54mm_Vertical_SMD_Pin1Left
R1, R2, R5, R6, R8: 100R; R_0402_1005Metric
R7: 10k; R_0402_1005Metric
SW1, SW2: TL3305BF100QG; TL3305BF160QG; Mouser Part Number 612-TL3305BF100QG
XTAL1: CX2016DB32000D0FLJCC; xtal4_CX2016DB_AVX

Connections:
+3.3V: IC1.2 (VDDSMPS), IC1.8 (VDDA), IC1.11 (VDD_1), IC1.22 (VDD_2), IC1.35 (VDD_3), IC1.40 (VDDRF), IC1.44 (VDD_4), J3.1, SW1.3; also elsewhere on the board
/BOOT0: C1.2, IC1.34 (PH3-BOOT0), R6.1, R7.2
/IIC/IIC_SCL: IC1.30 (PB2); also elsewhere on the board
/IIC/IIC_SDA: IC1.31 (PB1); also elsewhere on the board
/LED: D1.2 (A), IC1.25 (PA15)
/OSC_IN: C3.1, IC1.42 (OSC_IN), XTAL1.1
/OSC_OUT: C4.2, IC1.41 (OSC_OUT), XTAL1.3
/Power switching and voltage adaptation/VBUS: IC1.13 (VDDUSB); also elsewhere on the board
/RF: IC1.37 (RF); also elsewhere on the board
/SWCLK: IC1.27 (PA13), J3.5
/SWDIO: IC1.26 (PA14), J3.4
/SWD_NRST: C2.1, J3.3, R8.1, SW2.1
/SWD_Traces: IC1.32 (PB0), J3.6
/USART2_RX: IC1.5 (PA8), R2.2
/USART2_RX_CONN: J4.3, R2.1
/USART2_TX: IC1.4 (PB12), R1.2
/USART2_TX_CONN: J4.2, R1.1
/USB-C circuit/D-: IC1.17 (OTG_HS_DM)
/USB-C circuit/USB_D+: IC1.16 (OTG_HS_DP); also elsewhere on the board
/VDD11: IC1.39 (VDDANA), IC1.43 (VDDRFPA), IC1.45 (VDD11); also elsewhere on the board
/VDDHPA: IC1.38 (VDDHPA); also elsewhere on the board
/VLXSMPS: IC1.3 (VLXSMPS); also elsewhere on the board
GND: C1.1, C2.2, C3.2, C4.1, IC1.1 (VSSSMPS), IC1.49 (VSS), J2.3, J3.2, J4.1, R5.1, R7.1, SW2.2, XTAL1.2 (GND), XTAL1.4 (GND); also elsewhere on the board
unnamed: D1.1 (K), R5.2
unnamed: IC1.36 (NRST), R8.2
unnamed: R6.2, SW1.4

Notes on the sheet:
Traces
The 100R resistor is ESD protection apparently
R12 and C3 in combo with the pulldown resistor form a low-pass filter for button debouncing
Connector for the powerboard line (battery 5V)
Cl = 2(CL-Cs) = 2(8-3) = 10 pF
Flash button
SWD/JTAG is for debug and flashing (apparently UART can also be used for flashing ?) IO & CLK are important, Trace is for additional debug capability or can be GPIO if needed
Reset button
GND
SWCLK
NRST
SWDIO
SWD/JTAG
USART_2
CL = (Cl1*Cl2)/(Cl1+Cl2) + Cs CL = crystal's load capacitance = 8 Cs = stray capacitance (assumed 3pF) Cl1= Cl2 = pierce oscillator's capacitors Cl
Oscillator
Push and maintain button BEFORE board power-up (or reset) to enter flashing mode
VCC

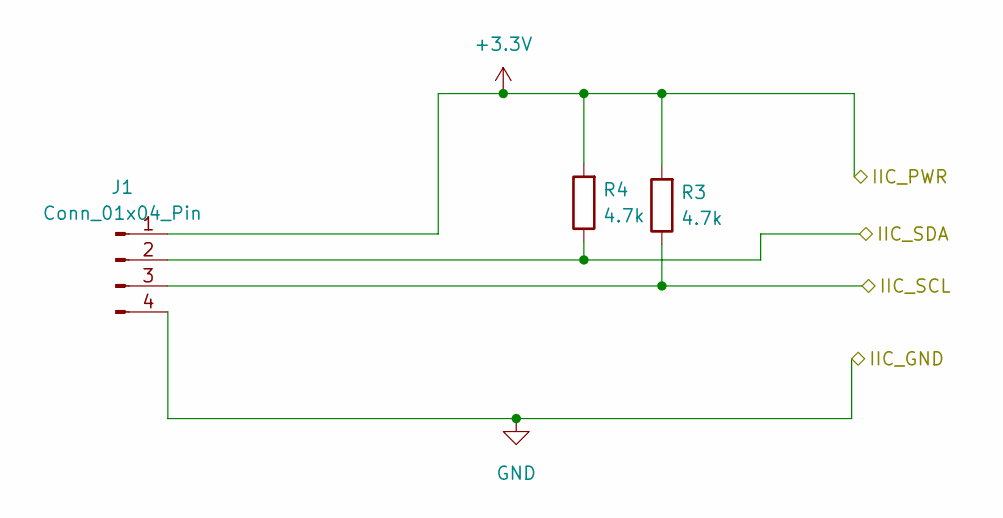
[picture p25: schematic IIC.kicad_sch]

Parts:
J1: Conn_01x04_Pin; JST_PH_B4B-PH-K_1x04_P2.00mm_Vertical
R3, R4: 4.7k; R_0603_1608Metric

Connections:
+5V: J1.1, R3.2, R4.2; also elsewhere on the board
/IIC/IIC_SCL: J1.3, R3.1; also elsewhere on the board
/IIC/IIC_SDA: J1.2, R4.1; also elsewhere on the board
GND: J1.4; also elsewhere on the board

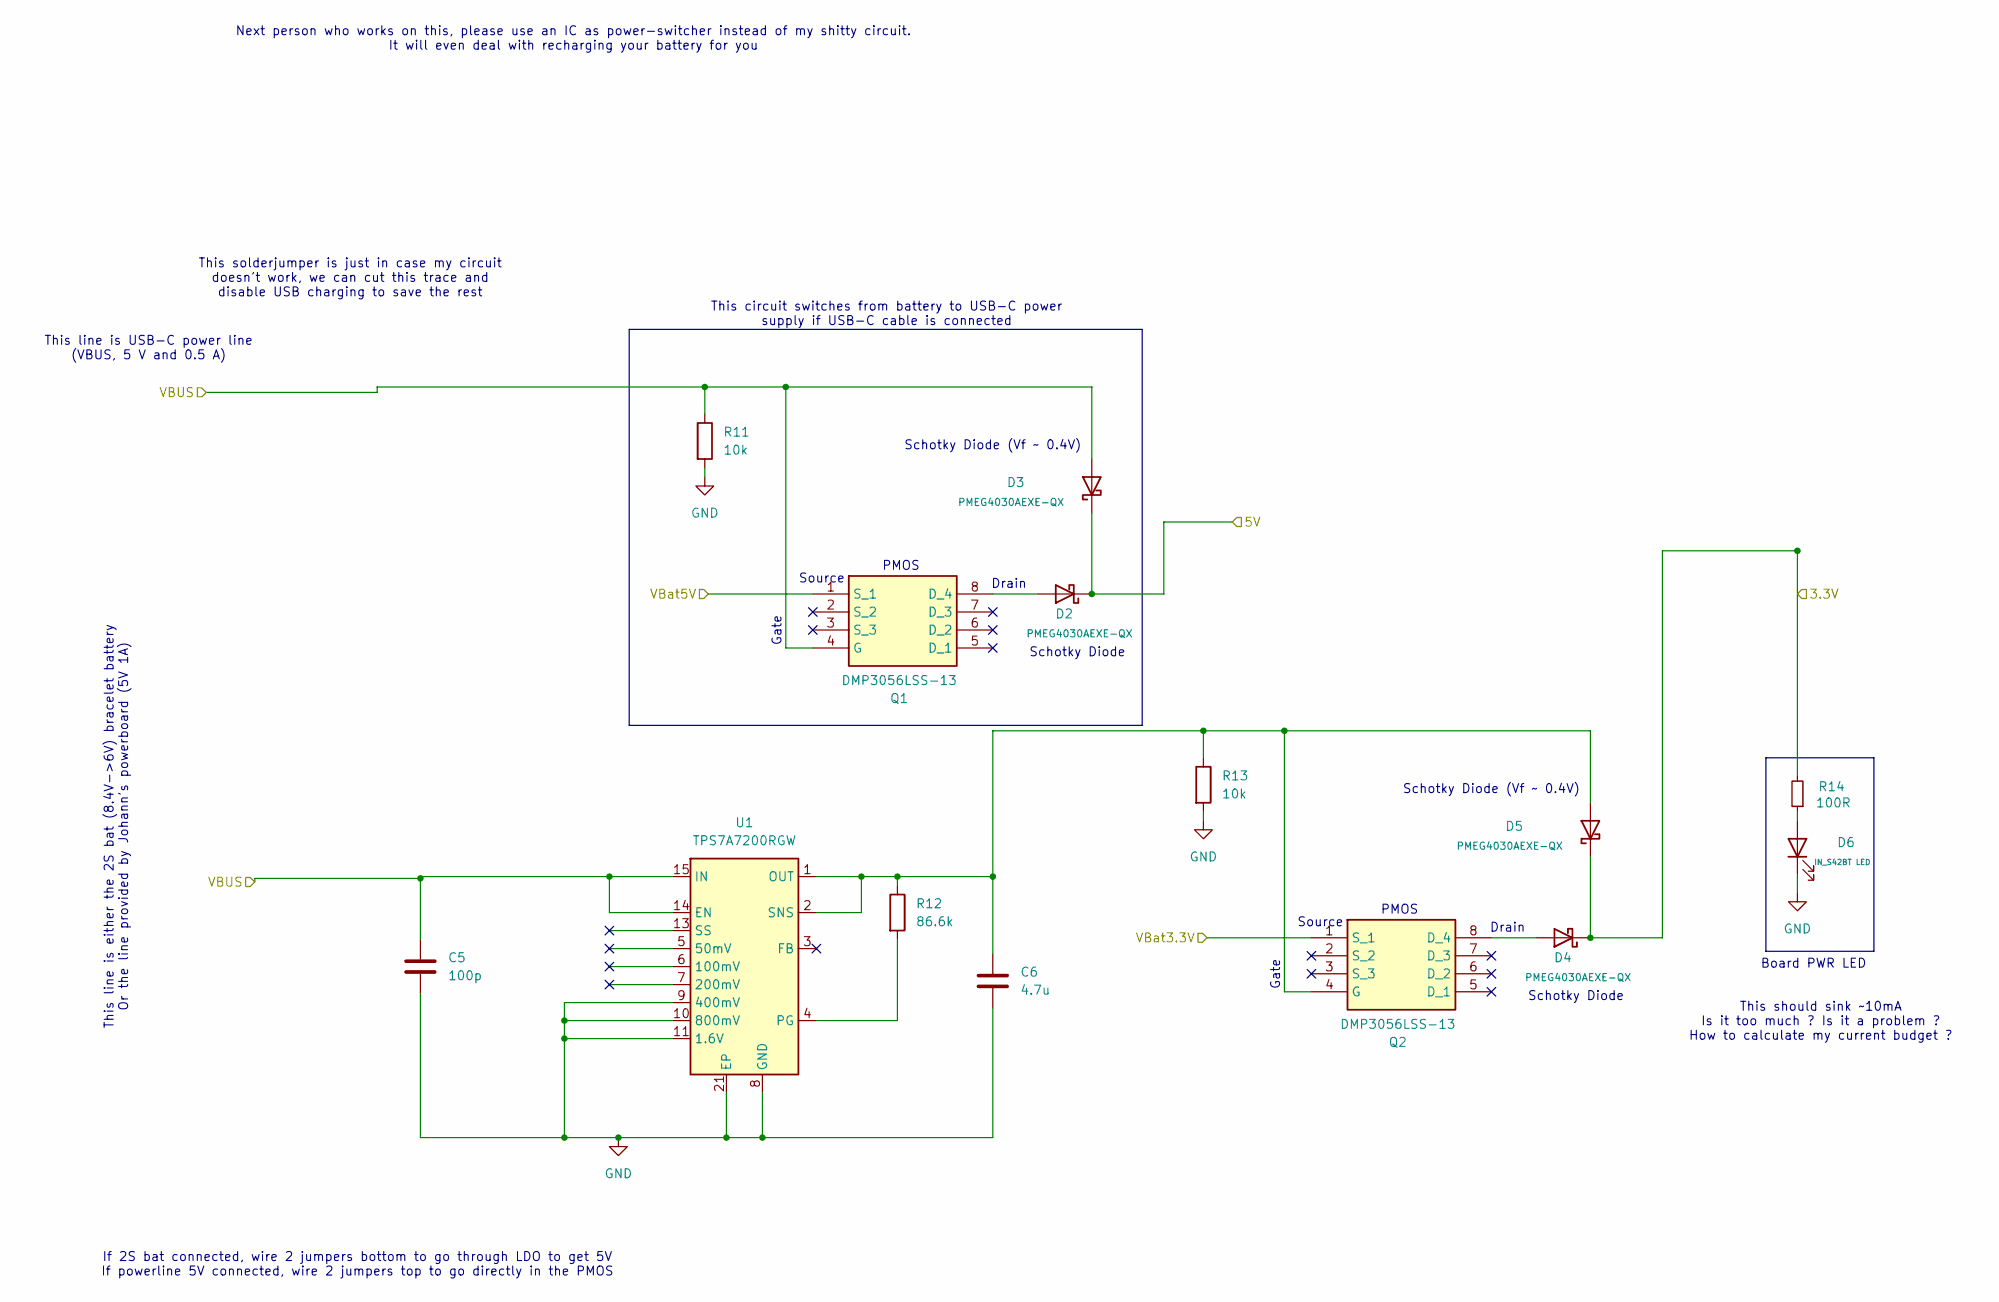
[picture p26: schematic voltage_adaptation.kicad_sch]

Parts:
C5: 100p; C_0603_1608Metric
C6: 4.7u; C_0402_1005Metric
D2, D3, D4, D5: PMEG4030AEXE-QX; PMEG4030AEXEQX; Manufacturer_Part_Number PMEG4030AEXE-QX
D6: IN_S42BT LED; LED_0402_1005Metric
Q1, Q2: DMP3056LSS-13; SOIC127P600X170-8N; Mouser Part Number 621-DMP3056LSS-13
R11, R13: 10k; R_0402_1005Metric
R12: 86.6k; R_0603_1608Metric
R14: 100R; R_0402_1005Metric
U1: TPS7A7200RGW; Texas_RGW0020A_VQFN-20-1EP_5x5mm_P0.65mm_EP3.15x3.15mm_Ther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

Connections:
+3.3V: D4.1 (K), D4.3 (K), D5.1 (K), D5.3 (K), R14.2; also elsewhere on the board
+5V: D2.1 (K), D2.3 (K), D3.1 (K), D3.3 (K); also elsewhere on the board
/Power: Q1.1 (S_1); also elsewhere on the board
/Power switching and voltage adaptation/VBUS: C5.1, D3.2 (A), Q1.4 (G), R11.1, U1.14 (EN), U1.15 (IN), U1.16 (IN), U1.17 (IN); also elsewhere on the board
/Power switching and voltage adaptation/VBat3.3V: Q2.1 (S_1); also elsewhere on the board
GND: C5.2, C6.2, D6.1 (K), R11.2, R13.2, U1.8 (GND), U1.9 (400mV), U1.10 (800mV), U1.11 (1.6V), U1.18 (GND), U1.21 (EP); also elsewhere on the board
unnamed: D2.2 (A), Q1.8 (D_4)
unnamed: D4.2 (A), Q2.8 (D_4)
unnamed: C6.1, D5.2 (A), Q2.4 (G), R12.1, R13.1, U1.1 (OUT), U1.2 (SNS), U1.19 (OUT), U1.20 (OUT)
unnamed: D6.2 (A), R14.1
unnamed: R12.2, U1.4 (PG)

Notes on the sheet:
Drain
This solderjumper is just in case my circuit doesn't work, we can cut this trace and disable USB charging to save the rest
Gate
Schotky Diode
If 2S bat connected, wire 2 jumpers bottom to go through LDO to get 5V If powerline 5V connected, wire 2 jumpers top to go directly in the PMOS
Board PWR LED
PMOS
Next person who works on this, please use an IC as power-switcher instead of my shitty circuit. It will even deal with recharging your battery for you
Source
This line is either the 2S bat (8.4V->6V) bracelet battery Or the line provided by Johann's powerboard (5V 1A)
Schotky Diode (Vf ~ 0.4V)
This should sink ~10mA Is it too much ? Is it a problem ? How to calculate my current budget ?
This line is USB-C power line (VBUS, 5 V and 0.5 A)
This circuit switches from battery to USB-C power supply if USB-C cable is connected

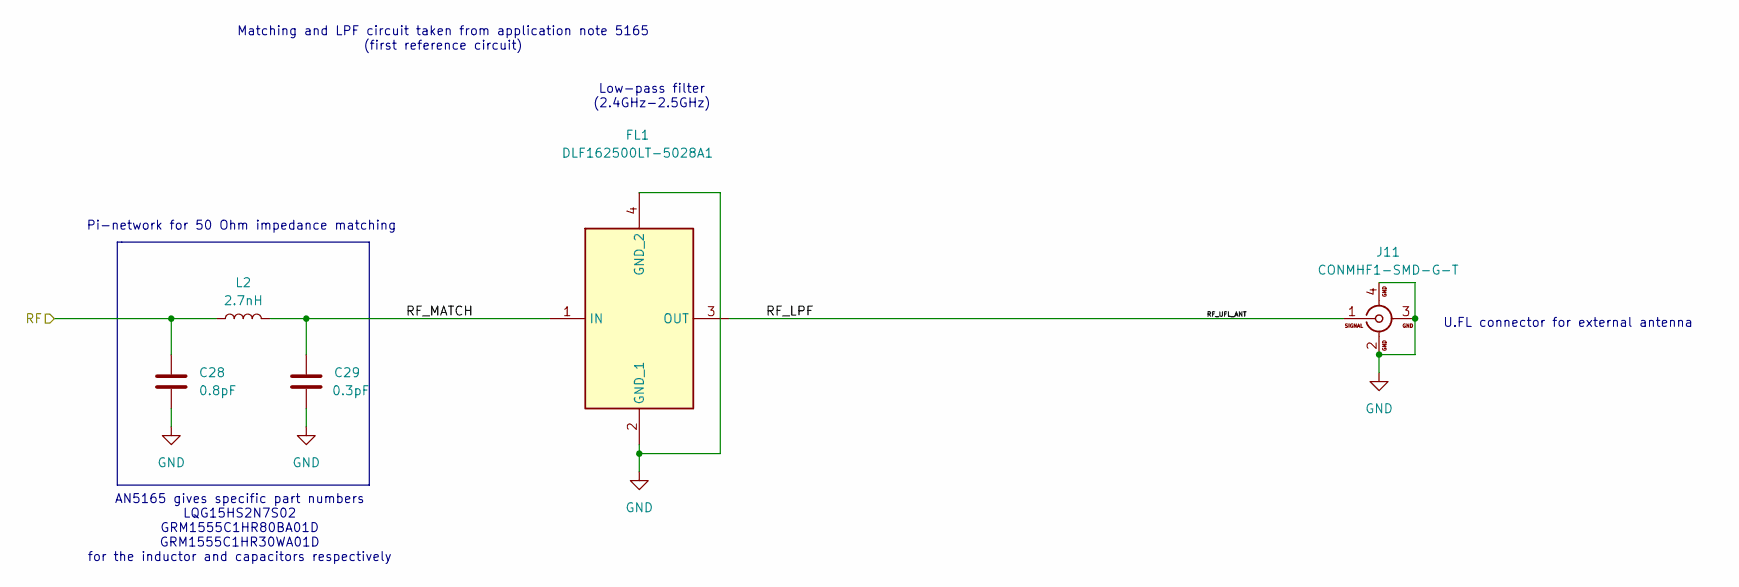
[picture p27: schematic RF.kicad_sch]

Parts:
C28: 0.8pF; C_0402_1005Metric
C29: 0.3pF; C_0402_1005Metric
FL1: DLF162500LT-5028A1; DLF162500LT5028A1; Mouser Part Number 810-DLF16250LT5028A1
J11: CONMHF1-SMD-G-T; CONMHF1SMDGT; Mouser Part Number 712-CONMHF1-SMD-G-T
L2: 2.7nH; L_0402_1005Metric

Connections:
/RF: C28.1, L2.1; also elsewhere on the board
/RF circuitry & antennas/RF_LPF: FL1.3 (OUT), J11.1
/RF circuitry & antennas/RF_MATCH: C29.1, FL1.1 (IN), L2.2
GND: C28.2, C29.2, FL1.2 (GND_1), FL1.4 (GND_2), J11.2, J11.3, J11.4; also elsewhere on the board

Notes on the sheet:
U.FL connector for external antenna
Pi-network for 50 Ohm impedance matching
Matching and LPF circuit taken from application note 5165 (first reference circuit)
AN5165 gives specific part numbers LQG15HS2N7S02 GRM1555C1HR80BA01D GRM1555C1HR30WA01D for the inductor and capacitors respectively
Low-pass filter (2.4GHz-2.5GHz)
