constancees/BMI-EMG-HW-Constance/Board V3/Processing_board.kicad_pcb

## KiCad design Board V3/Processing_board.kicad_pcb (continued)

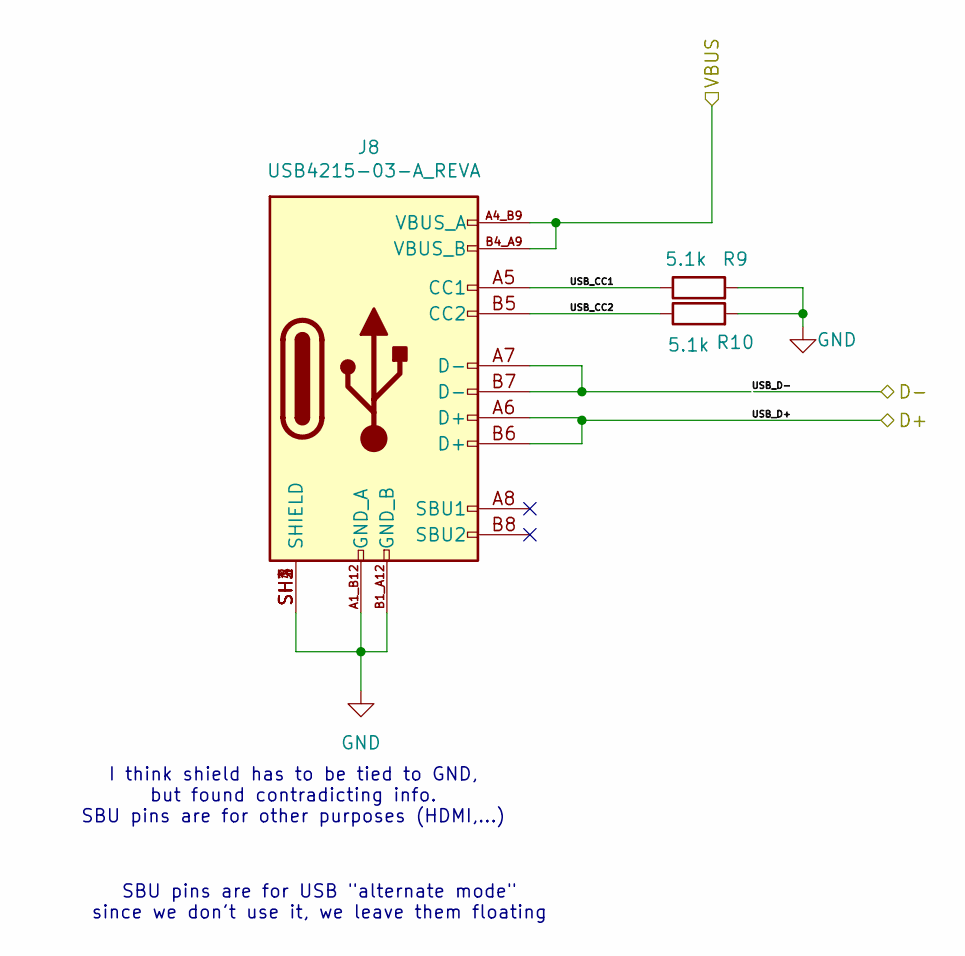
[picture p28: schematic usb_c.kicad_sch]

Parts:
J8: USB4215-03-A_REVA; GCT_USB4215-03-A_REVA; PARTREV A
R9, R10: 5.1k; R_0402_1005Metric

Connections:
/Power switching and voltage adaptation/VBUS: J8.A4_B9 (VBUS_A), J8.B4_A9 (VBUS_B); also elsewhere on the board
/USB-C circuit/USB_CC1: J8.A5 (CC1), R9.1
/USB-C circuit/USB_CC2: J8.B5 (CC2), R10.1
/USB-C circuit/USB_D+: J8.A6 (D+), J8.B6 (D+); also elsewhere on the board
/USB-C circuit/USB_D-: J8.A7 (D-), J8.B7 (D-)
GND: J8.A1_B12 (GND_A), J8.B1_A12 (GND_B), J8.SH1 (SHIELD), J8.SH2 (SHIELD), J8.SH3 (SHIELD), J8.SH4 (SHIELD), R9.2, R10.2; also elsewhere on the board

Notes on the sheet:
I think shield has to be tied to GND, but found contradicting info. SBU pins are for other purposes (HDMI,...)
SBU pins are for USB "alternate mode" since we don't use it, we leave them floating

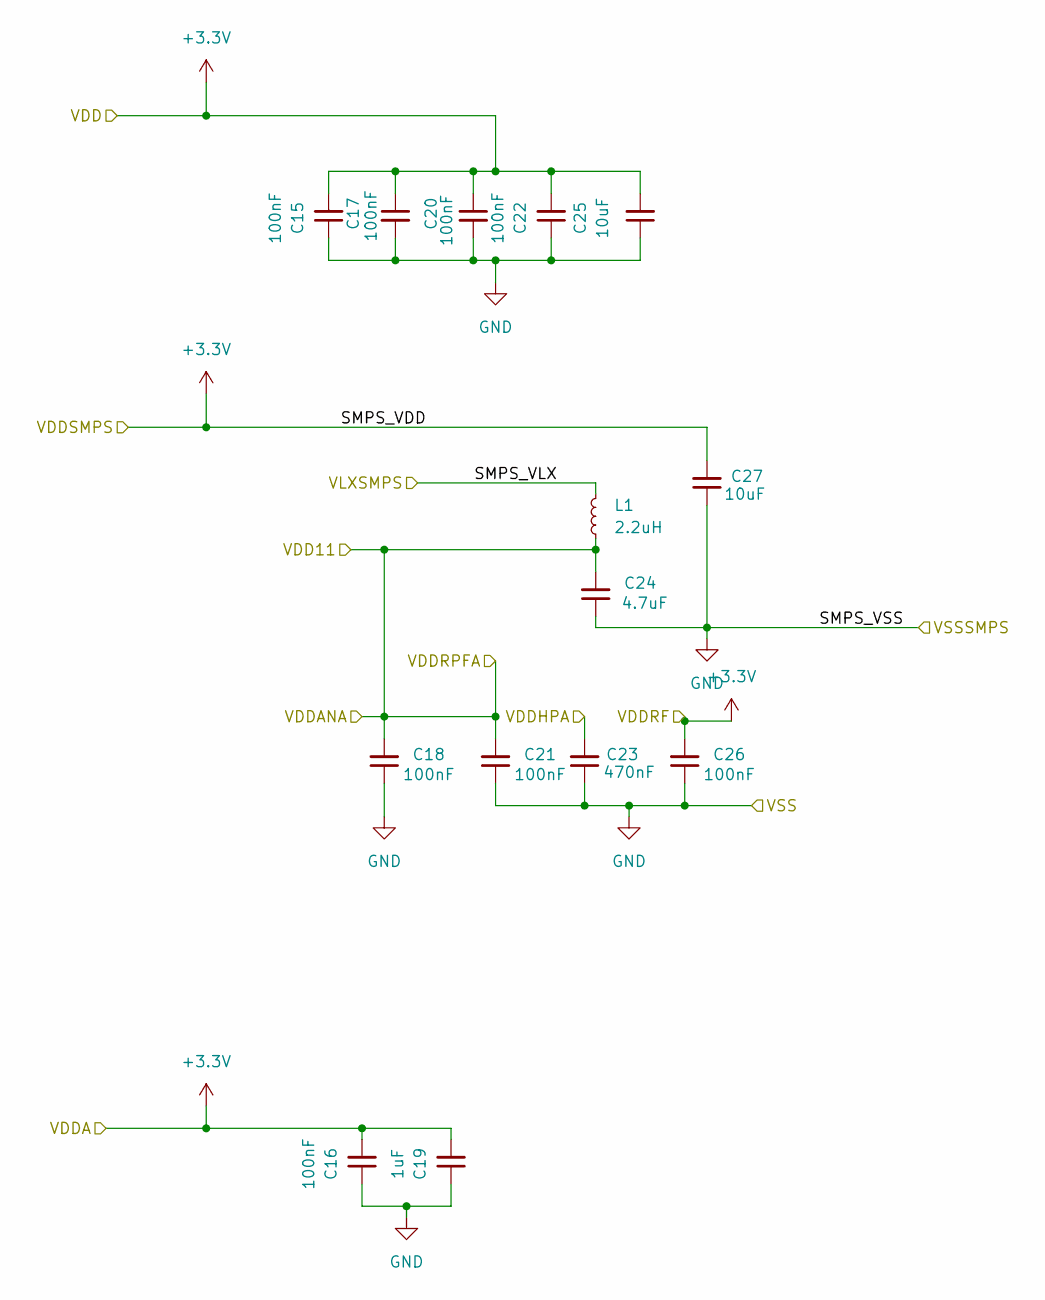
[picture p29: schematic STM32_power_supply_scheme.kicad_sch]

Parts:
C15, C16, C17, C18, C20, C21, C22, C26: 100nF; C_0402_1005Metric
C19: 1uF; C_0402_1005Metric
C23: 470nF; C_0402_1005Metric
C24: 4.7uF; C_0402_1005Metric
C25, C27: 10uF; C_0402_1005Metric
L1: 2.2uH; L_0805_2012Metric

Connections:
+3.3V: C15.2, C16.2, C17.1, C19.2, C20.1, C22.2, C25.2, C26.2, C27.2; also elsewhere on the board
/VDD11: C18.2, C21.2, C24.2, L1.1; also elsewhere on the board
/VDDHPA: C23.2; also elsewhere on the board
/VLXSMPS: L1.2; also elsewhere on the board
GND: C15.1, C16.1, C17.2, C18.1, C19.1, C20.2, C21.1, C22.1, C23.1, C24.1, C25.1, C26.1, C27.1; also elsewhere on the board

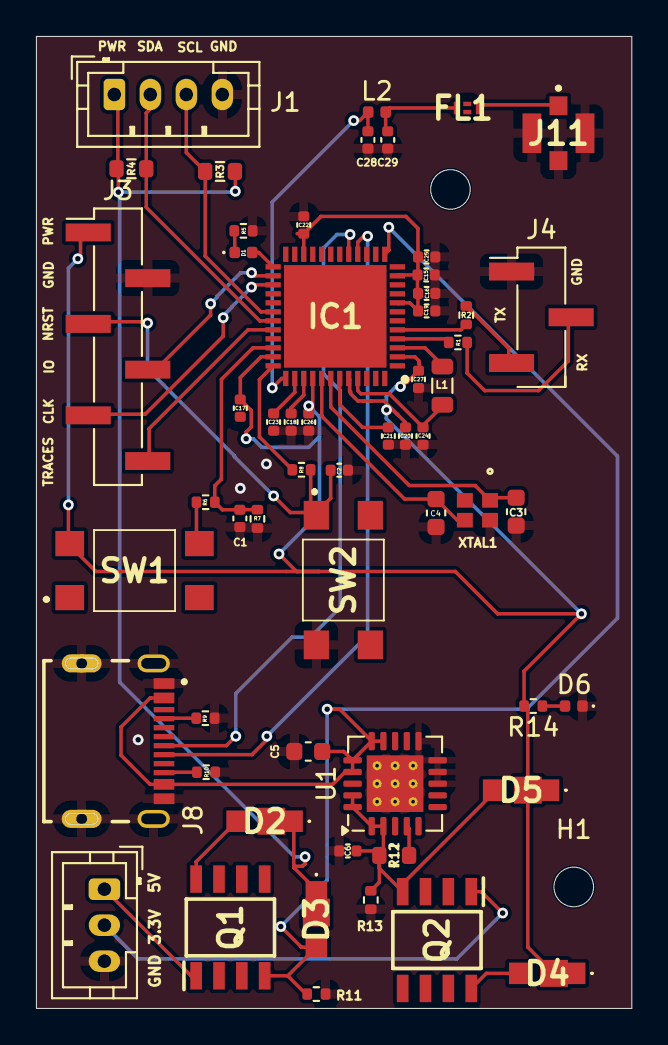
[picture p30: board Processing_board.kicad_pcb from above]

Board: 2 copper layers, 33.1 x 54.0 mm, 59 parts (0 on the bottom side), 38 nets.

Other parts of the board:
5V: Conn_01x03_Pin; JST_PH_B3B-PH-K_1x03_P2.00mm_Vertical

Their connections:
/Power: 5V.1; also elsewhere on the board
/Power switching and voltage adaptation/VBat3.3V: 5V.2; also elsewhere on the board
GND: 5V.3; also elsewhere on the board
