constancees/BMI-EMG-HW-Constance/(commit log)

2026-05-24 Bracelets 2025-2026 ajoutés
    [Assembly - Canal v12.iges, Assembly - Control Board v1.iges, Canal - Assembly v11.iges, Canal - Middle plate v10.f3d, Canal - base v21.f3d, Canal - base v22.f3d, Canal - blocker v2.f3d, Canal - main base v2.iges]
2026-09-28 Add initial PowerBoard v3 files
    [5to3.3V.kicad_sch, Converison battery-5V.kicad_sch, RECHARGE.kicad_sch, power_v3.0.kicad_sch]
2026-09-28 cleaned up repo
    [5to3.3V.kicad_sch, Converison battery-5V.kicad_sch, RECHARGE.kicad_sch, try.kicad_pcb]
2026-09-28 added TVS diodes to charging circuit and (almost fully) routed 5.3 to 5V LDO
    [5to3.3V.kicad_sch, RECHARGE.kicad_sch, power_v3.0.kicad_sch]
2026-09-29 updated file names and added hierarchy schematic, problem with ERC bc of GND
    [5.3to5V.kicad_sch, Conversion battery-5.3V.kicad_sch, RECHARGE.kicad_sch, power_v3.0.kicad_sch]
2026-09-30 Fixed diode layout, added C to VBUS and protection to BUCK-LDO interface
    [5.3to5V.kicad_sch, Conversion battery-5.3V.kicad_sch, RECHARGE.kicad_sch]
2026-09-30 updated text on LDO
    [5.3to5V.kicad_sch]
2026-09-30 updated text boxes
    [5.3to5V.kicad_sch, Conversion battery-5.3V.kicad_sch]
2026-10-02 minor fixes, last save before 3.1
    [RECHARGE.kicad_sch]
2026-10-02 add initial v3.1 files
    [5.3to5V_v3.1.kicad_sch, Conversion battery-5.3V_v3.1.kicad_sch, RECHARGE_v3.1.kicad_sch, power_v3.1.kicad_sch]
2026-10-03 Added a comparator circuit that disables the buck converter when temp is too high and re enables it when it reaches a lower temperature
    [Conversion battery-5.3V_v3.1.kicad_sch, RECHARGE_v3.1.kicad_sch]
2026-10-04 Final changes before v3.2
    [RECHARGE_v3.1.kicad_sch, power_v3.1.kicad_sch]
2026-10-04 Add initial v3.2 files
    [5.3to5V_v3.2.kicad_sch, Conversion battery-5.3V_v3.2.kicad_sch, RECHARGE_v3.2.kicad_sch, power_v3.2.kicad_sch]
2026-10-04 added TMP300 IC to measure temperature and corresponding resistor values
    [RECHARGE_v3.2.kicad_sch]
2026-10-06 Received new battery. last commit before v3.3
2026-10-06 add initial v3.3 files
    [5.3to5V_v3.3.kicad_sch, Conversion battery-5.3V_v3.3.kicad_sch, RECHARGE_v3.3.kicad_sch, power_v3.3.kicad_sch]
2026-10-07 added footprints
    [5.3to5V_v3.3.kicad_sch, 74438336010.SchLib, 74438336010.stp, Conversion battery-5.3V_v3.3.kicad_sch, EDI2CAP.CFG, INDC3030X200N.PcbLib, RECHARGE_v3.3.kicad_sch, chips.prt]
2026-10-08 finished footprint assignment, added on-off general switch
    [5.3to5V_v3.3.kicad_sch, Conversion battery-5.3V_v3.3.kicad_sch, RECHARGE_v3.3.kicad_sch, UJ20-C-H-G-SMT-1-P16-TR.step, power_v3.3.kicad_pcb]
2026-10-08 (nearly) finished schematic and layout, beginning routing (hooooooly)
    [5.3to5V_v3.3.kicad_sch, Conversion battery-5.3V_v3.3.kicad_sch, RECHARGE_v3.3.kicad_sch, power_v3.3.kicad_pcb]
2026-10-09 updated routing
    [5.3to5V_v3.3.kicad_sch, power_v3.3.kicad_pcb]
2026-10-09 updated routing, added mounting holes
    [RECHARGE_v3.3.kicad_sch, power_v3.3.kicad_pcb, power_v3.3.kicad_sch]
2026-10-09 added .stp files and extra layout changes, 1 extra mounting hole
    [2053380002.stp, 2053380003.stp, 5.3to5V_v3.3.kicad_sch, 5MS1S102AM6QES.stp, 78438336022.stp, AP2281-1FMG-7.stp, Conversion battery-5.3V_v3.3.kicad_sch, MAX25301AATB_V+T.stp]
2026-10-09 changed battery connection
    [43650-0300.stp, RECHARGE_v3.3.kicad_sch, power_v3.3.kicad_pcb]
