constancees/BMI-EMG-HW-Constance/(notices)

Notices in the files:
POWERBOARD v3/power_v3.3/MFS201N-9-Z/MFS201N-9-Z.stp:
author */ ('License CC BY-ND 4.0'),
